FishyG/RobotSumo2022/README.md

# RobotSumo2022

Hello test :)

Hi test. I'm funny.
