FishyG/RobotSumo2022/Parts.md

# Digikey.ca:
## Alimentation découpage:
| No | Description | Prix unitaire | Qté |
|---|---|---|---|
| 718-2114-1-ND | CAP TANT POLY 100UF 6.3V 1206 | $1.041 | 50 |
| SK54B-LTPMSCT-ND  | DIODE SCHOTTKY 40V 5A DO214AA | $0.3854 | 100 |
| 296-38111-1-ND | IC REG CTRLR MULT TOPOLOGY 8SOIC  | $3.3708 | 25 |
| | | | |
| 296-25260-1-ND | MOSFET N-CH 25V 5A 6SON | $0.754 | 25 |
| | | | |
| 553-2864-ND | FIXED IND 2.7UH 3.5A 16 MOHM SMD  | $2.232 | 25 |
| PRL1632.015FCT-ND | RES 0.015 OHM 1W 1206 WIDE | $0.727 | 25 |
| PRL1632.009FCT-ND | RES 0.009 OHM 1W 1206 WIDE | $0.88 | 25 |

## Régulateurs:
| No | Description | Prix unitaire | Qté |
|---|---|---|---|
| LM1117MP-5.0/NOPBCT-ND | IC REG LINEAR 5V 800MA SOT223 | $1.552 | 25 |
| LM1117IMPX-3.3/NOPBCT-ND  | IC REG LIN 3.3V 800MA SOT223-4 | $1.40920 | 25 |
| TS3480CX33RFGCT-ND | Linear Voltage  3.3V 100mA SOT-23 | $0.8448 | 25 |
| MC33269DR2-5.06 | LINEAR REGULATOR 5v 800Ma SOIC-8  | ??? | 25 |

## USB à série:
| No | Description | Prix unitaire | Qté |
|---|---|---|---|
| 768-1007-1-ND | IC USB FS SERIAL UART 28-SSOP | $6.103 | 25 |
| 151-1206-1-ND | CONN RCPT USB2.0 MINI B SMD R/A | $0.6872 | 25 |
| 609-4618-1-ND | CONN RCPT USB2.0 MICRO B SMD R/A  | $0.4652 | 25 |

## Section processeur:
| No | Description | Prix unitaire | Qté |
|---|---|---|---|
| P8X32A-Q44-ND | IC MCU 32BIT 32KB ROM 44LQFP | $10.8316 | 25 |
| 644-1202-1-ND | CRYSTAL 5.0000MHZ 8PF SMD | $0.705 | 25 |
| 24LC512T-I/SNCT-ND | IC EEPROM 512KBIT I2C 8SOIC | $2.44 | 25 |

## Driver pour 1 moteur:
| No | Description | Prix unitaire | Qté |
|---|---|---|---|
| ZXBM5210-S-13DICT-ND  | IC MOTOR DRIVER 3V-18V 8SO | $1.524 | 50 |

# Mouser.ca: 
## Alimentation découpage:
| No | Description | Prix unitaire | Qté |
|---|---|---|---|
| 926-LM3478MA/NOPB | IC REG CTRLR MULT TOPOLOGY 8SOIC | $3.46 | 30 |
| 667-16SVPE180M | 180 µF 16 V Aluminum - Polymer Capacitors | $1.59 | 25 |
| | Radial, Can - SMD 11mOhm 2000 Hrs @ 105°C | | |

# IDK :shrug:
## Etc.
| No | Description | Prix unitaire | Qté |
|---|---|---|---|
| N/A | TCRT5000 - Capteur de sol | N/A | N/A |
| N/A | TL1838 - Capteur de proximité: | N/A | N/A |
| N/A | IR204 - DEL IR | N/A | N/A |
