FishyG/RobotSumo2022/3D/RobotSumoBody/body.FCStd

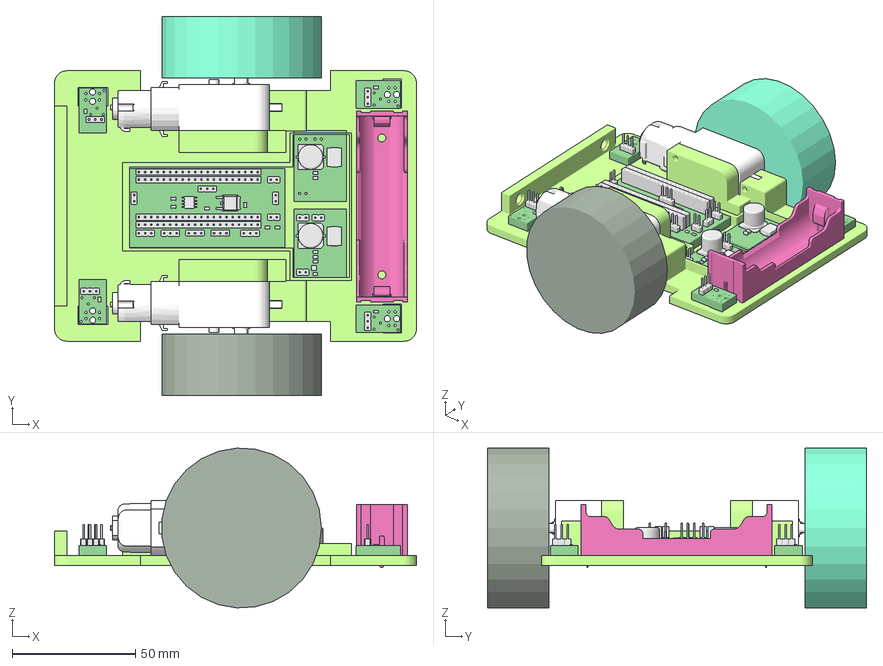
[picture p18: CAD file, 2022-12-01]
3D/RobotSumoBody/body.FCStd
147.0 x 154.0 x 64.9 mm
_autosave-Carte Mere PCB002
_autosave-Carte Mere PCB005
_autosave-Carte Mere PCB003
_autosave-Carte Mere PCB
_autosave-Carte Mere PCB006
_autosave-PowerSupply PCB002
_autosave-PowerSupply PCB001
wheel001
wheel002
DC Motor gearbox002
DC Motor gearbox001
18650_Holder
