FishyG/RobotSumo2022/3D/step/DC_Motor_20mm.STEP

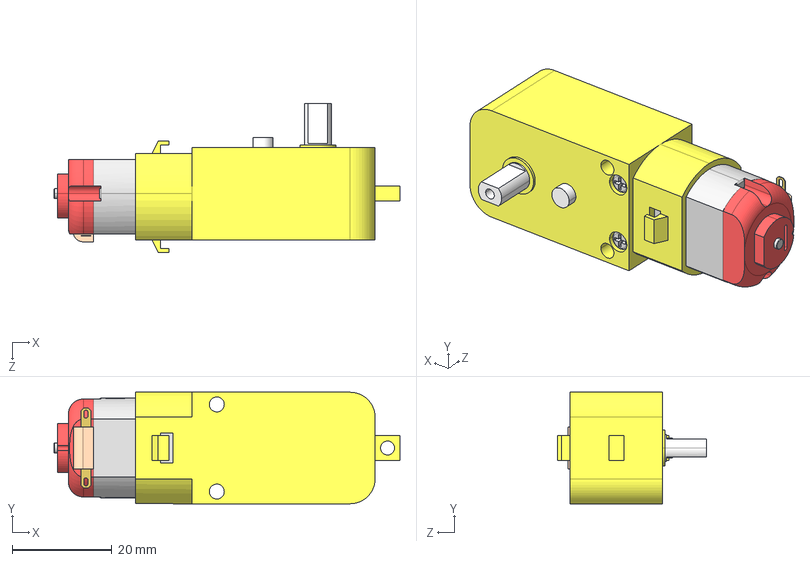
[picture p19: CAD file, 2022-12-01]
3D/step/DC_Motor_20mm.STEP
69.5 x 22.4 x 29.9 mm
