FishyG/RobotSumo2022/3D/stl/CpuBoard.stl

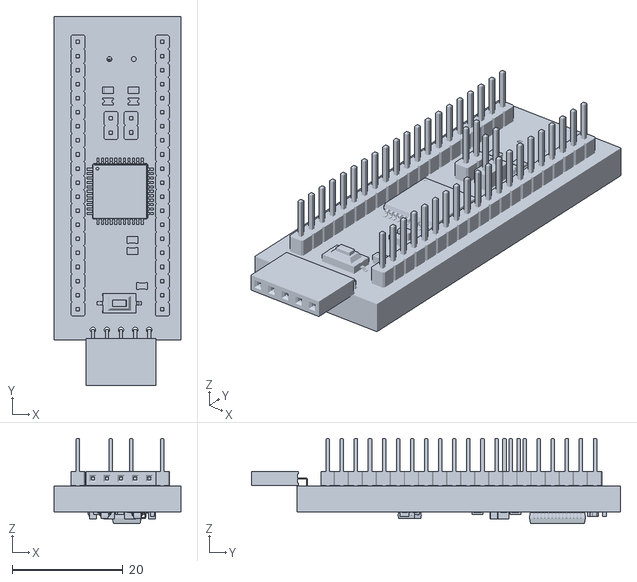
[picture p20: CAD file, 2022-10-06]
3D/stl/CpuBoard.stl
22.9 x 66.6 x 15.4
