FishyG/RobotSumo2022/3D/step/PowerSupply.step

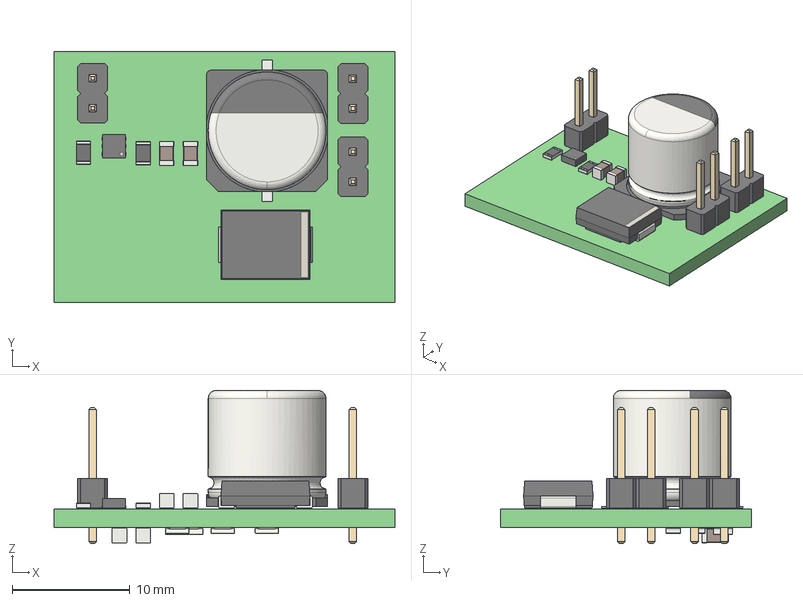
[picture p21: CAD file, 2022-10-06]
3D/step/PowerSupply.step
29.0 x 21.3 x 13.0 mm
_autosave-PowerSupply PCB
