FishyG/RobotSumo2022/3D/RobotSumoBody/body-Body.stl

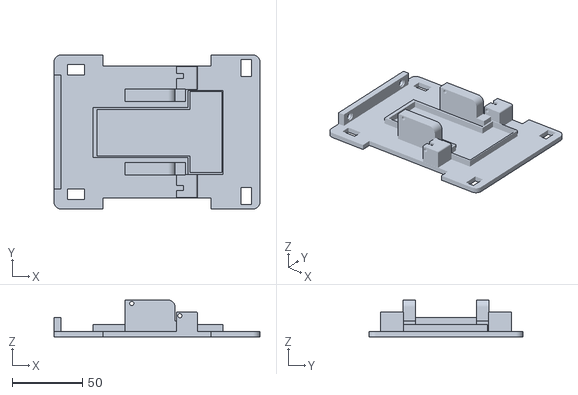
[picture p22: CAD file, 2022-12-01]
3D/RobotSumoBody/body-Body.stl
147.0 x 109.9 x 26.4
