FishyG/RobotSumo2022/3D/step/Capteur.step

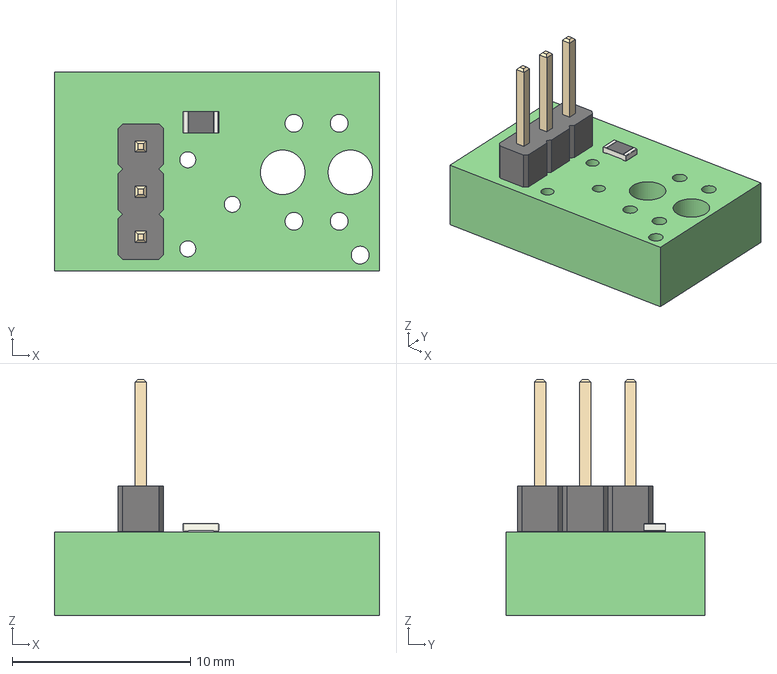
[picture p23: CAD file, 2022-10-06]
3D/step/Capteur.step
18.2 x 11.2 x 13.3 mm
_autosave-Carte Mere PCB
