FishyG/RobotSumo2022/3D/stl/CarteMere.stl

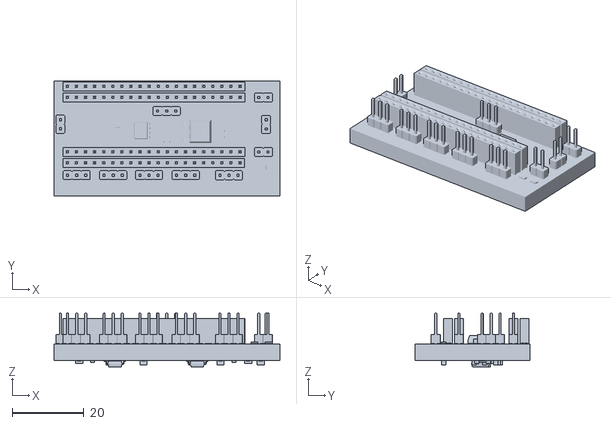
[picture p24: CAD file, 2022-10-06]
3D/stl/CarteMere.stl
63.2 x 32.2 x 15.1
