FishyG/RobotSumo2022/3D/stl/CpuBoardEsp.stl

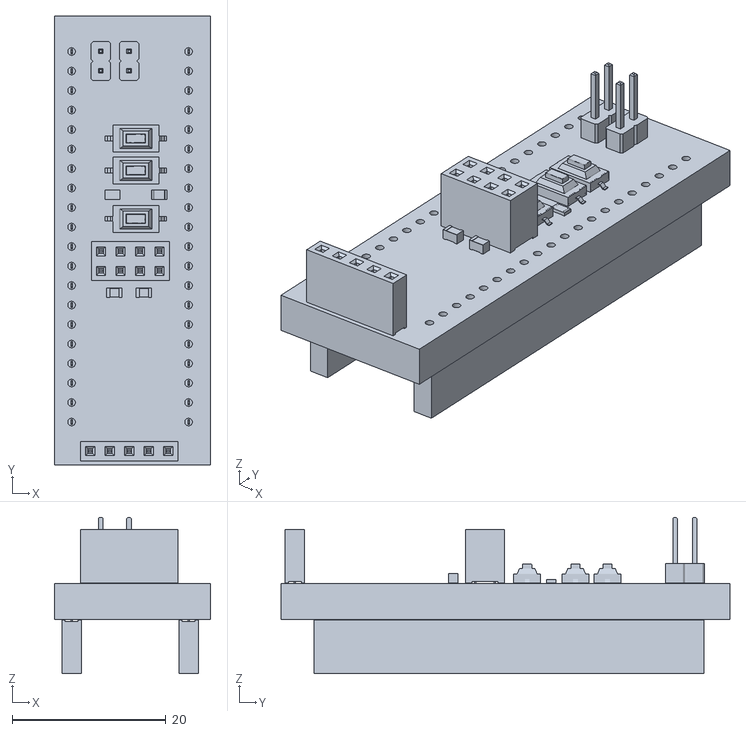
[picture p25: CAD file, 2022-10-06]
3D/stl/CpuBoardEsp.stl
20.3 x 58.4 x 20.3
