FishyG/RobotSumo2022/3D/stl/18650_Holderl.stl

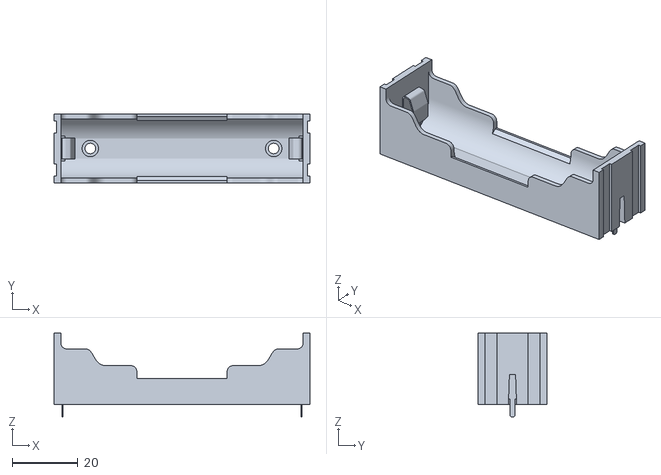
[picture p26: CAD file, 2022-10-06]
3D/stl/18650_Holderl.stl
77.7 x 20.8 x 25.5
