FishyG/RobotSumo2022/(list of files, cad)

Other CAD files:
Code/ControlRobotSumo/.objs/main.obj
Code/RobotSumoZP/.objs/main.obj
3D/RobotSumoBody/body-Motors_Wheels.stl
3D/stl/DC_Motor_20mm.STL
3D/stl/PowerSupply.stl
3D/stl/capteur.stl
