FishyG/RobotSumo2022/PCB/PowerSupply/WBDesign6V-2A_Startup.pdf

Rfadj 26.7 kOhm 63.0 m W; Com p; Isense; AGND PGND; Vin; Rcom p 2.74 kOhm 63.0 m W; Vout = 6.0V Iout = 2.0A D1 VF@Io= 550.0 m V VRRM= 40.0 V; Cin 100.0 µF 100.0 m Ohm; Cfilt 10.0 pF; Ccom p 18.0 nF 1.0 m Ohm; L1 2.7 µH 12.0 m Ohm; Rfilt 100.0 Ohm 63.0 m W; Ccom p2 1.0 nF 1.0 m Ohm; Cout 180.0 µF 11.0 m Ohm; Cbyp 100.0 nF 1.0 m Ohm; M1 VdsMax= 12.0 V IdsMax= 22.0 Am ps; Rsense 16.0 m Ohm 1.0 W; Rfb1 1000.0 Ohm 63.0 m W; Rfb2 3.74 kOhm 63.0 m W; Iout

Copyright © 2022, Texas Instruments Incorporated | 1 | ti.com/webench

WEBENCH®
Design Report LM3478MM/NOPB : LM3478MM/NOPB 3.5V-4.2V to 6.00V @ 2A August 25, 2022 10:10:40 GMT-05:00

## WEBENCH ® Design Report

Design : 4 LM3478MM/NOPB
LM3478MM/NOPB 3.5V-4.2V to 6.00V @ 2A

VinMin = 3.5V
VinMax = 4.2V
Vout = 6.0V
Iout = 2.0A

Device = LM3478MM/NOPB
Topology = Boost
Created = 2022-08-25 10:07:59.511 BOM Cost = $2.75
BOM Count = 16
Total Pd = 1.51W
1. With the low turn of voltage of the LM34x8 your power supply may current limit before you reach your working input voltage. If this happens, or to preempt this from happening, you can include a low pass RC filter from input voltage to Vin on the IC. Make sure the rise time on the RC network is slower than your supply's rise time.

## Electrical BOM

Name | Manufacturer | Part Number | Properties | Qty Price | Footprint
Cbyp | MuRata | GRM155R70J104KA01D (http://search.murata.co.jp/Ceramy/PnsearchViewAction.do) Series= X7R | Cap= 100.0 nF ESR= 1.0 mOhm VDC= 6.3 V IRMS= 0.0 A
1 | $0.01
| | | | | 0402 3 mm²
Ccomp | MuRata | GRM155R71C183KA01D (http://search.murata.co.jp/Ceramy/PnsearchViewAction.do) Series= X7R

Cap= 18.0 nF
ESR= 1.0 mOhm
VDC= 16.0 V
IRMS= 0.0 A

1 $0.01
0402 3 mm²
Ccomp2 | Yageo | CC0805KRX7R9BB102 (http://www.yageo.com/documents/recent/UPY%2DGPHC%5FX7R%5F6.3V%2Dto%2D50V%5F7.pdf) Series= X7R

Cap= 1.0 nF
ESR= 1.0 mOhm
VDC= 50.0 V
IRMS= 0.0 A

1 $0.01
0805 7 mm²
Cfilt | Samsung Electro- Mechanics | CL21C100JBANNNC (http://www.samsungsem.com/servlet/FileDownload?type%3Dspec%26file%3DCL21C100JBANNNC.pdf) Series= C0G/NP0 | Cap= 10.0 pF VDC= 50.0 V IRMS= 0.0 A
1 | $0.01
0805 7 mm²
Cin | Panasonic | 6TPH100MAEA Series= TPH | Cap= 100.0 uF ESR= 100.0 mOhm VDC= 6.3 V IRMS= 670.0 mA
1 | $0.32
CAPSMT_6_A09 11 mm²
Cout | Panasonic | 16SVPE180M Series= SVPE | Cap= 180.0 uF ESR= 11.0 mOhm VDC= 16.0 V IRMS= 4.46 A
1 | $0.50

CAPSMT_62_C10 74 mm²
D1 | Diodes Inc. | B540C-13-F (http://www.diodes.com/datasheets/ds13012.pdf) | VF@Io= 550.0 mV VRRM= 40.0 V
1 | $0.17

SMC 83 mm²

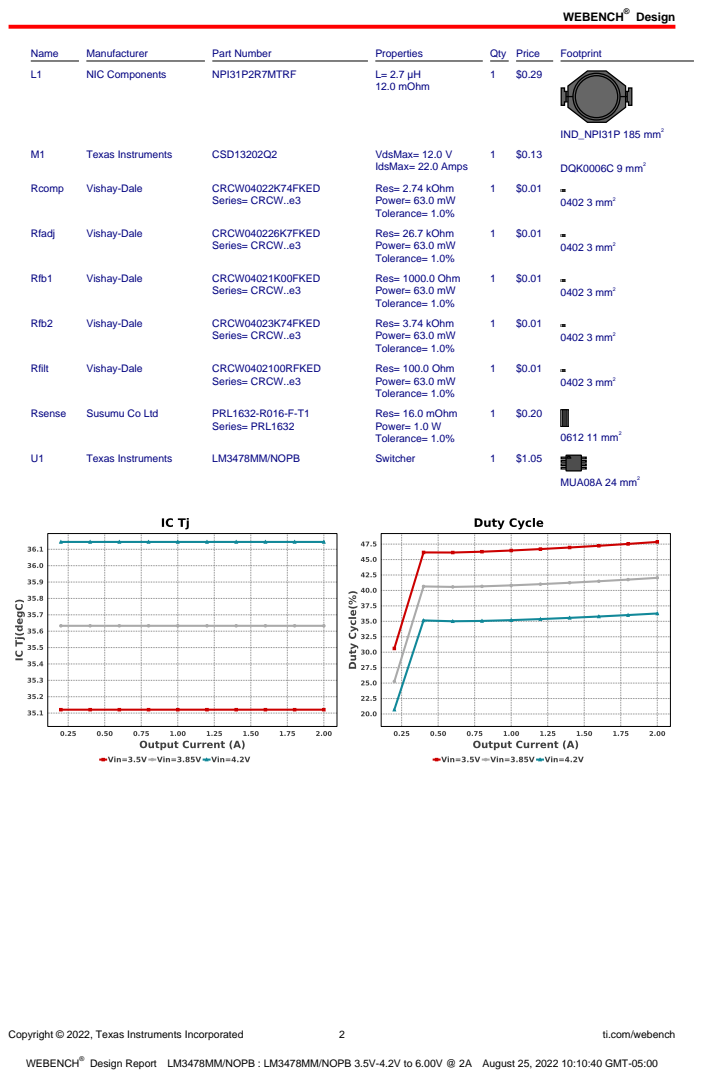
[picture p43: page 2]
Design; Copyright © 2022, Texas Instruments Incorporated; ti.com/webench; Name; Manufacturer; Part Number; Properties; Qty Price; Footprint; NIC Components; NPI31P2R7MTRF; 12.0 mOhm; IND_NPI31P 185 mm²; Texas Instruments; CSD13202Q2; VdsMax= 12.0 V; IdsMax= 22.0 Amps; DQK0006C 9 mm²; Rcomp; Vishay-Dale; CRCW04022K74FKED; Series= CRCW..e3; Res= 2.74 kOhm Power= 63.0 mW Tolerance= 1.0%; 0402 3 mm²; Rfadj; CRCW040226K7FKED; Res= 26.7 kOhm Power= 63.0 mW Tolerance= 1.0%; Rfb1; CRCW04021K00FKED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

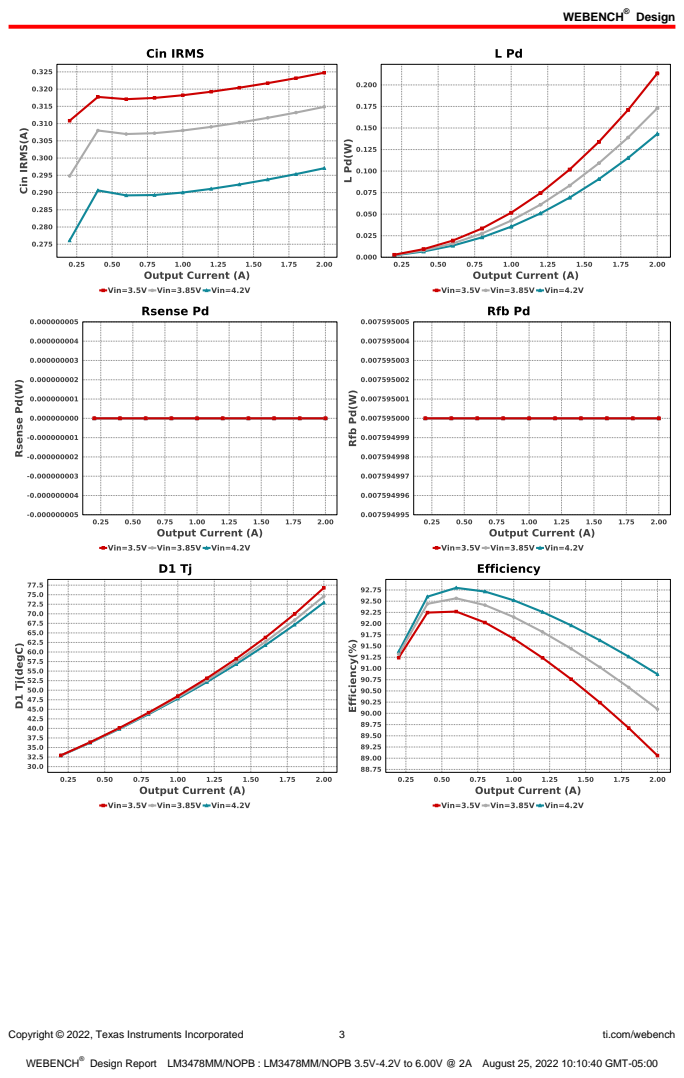
[picture p44: page 3]
Copyright © 2022, Texas Instruments Incorporated; ti.com/webench

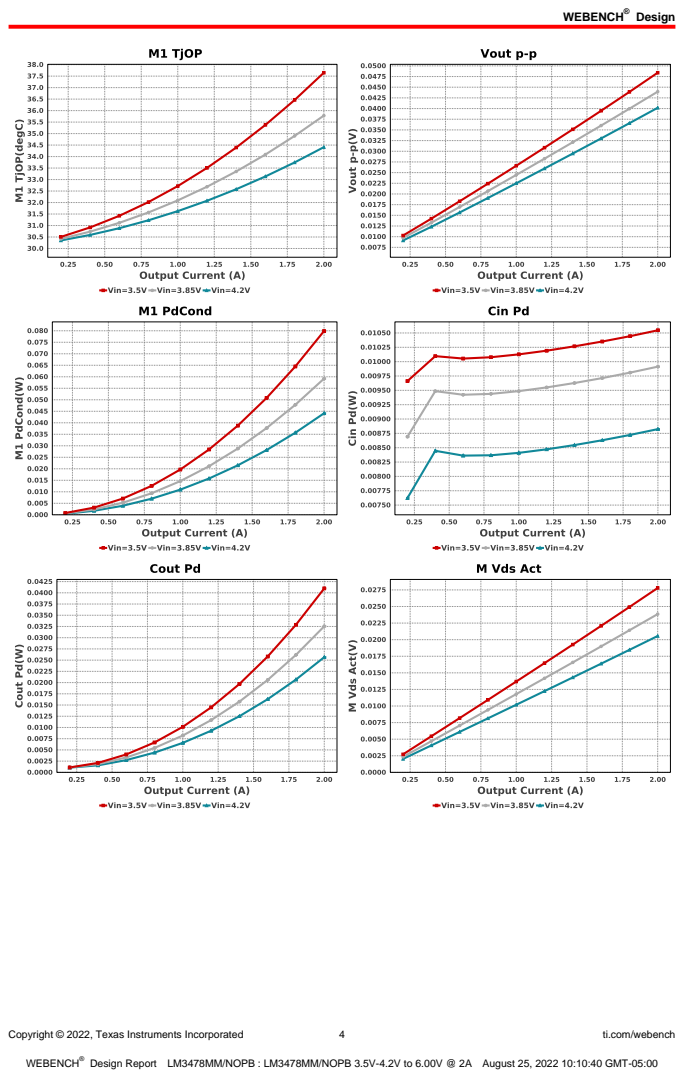
[picture p45: page 4]
Copyright © 2022, Texas Instruments Incorporated; ti.com/webench

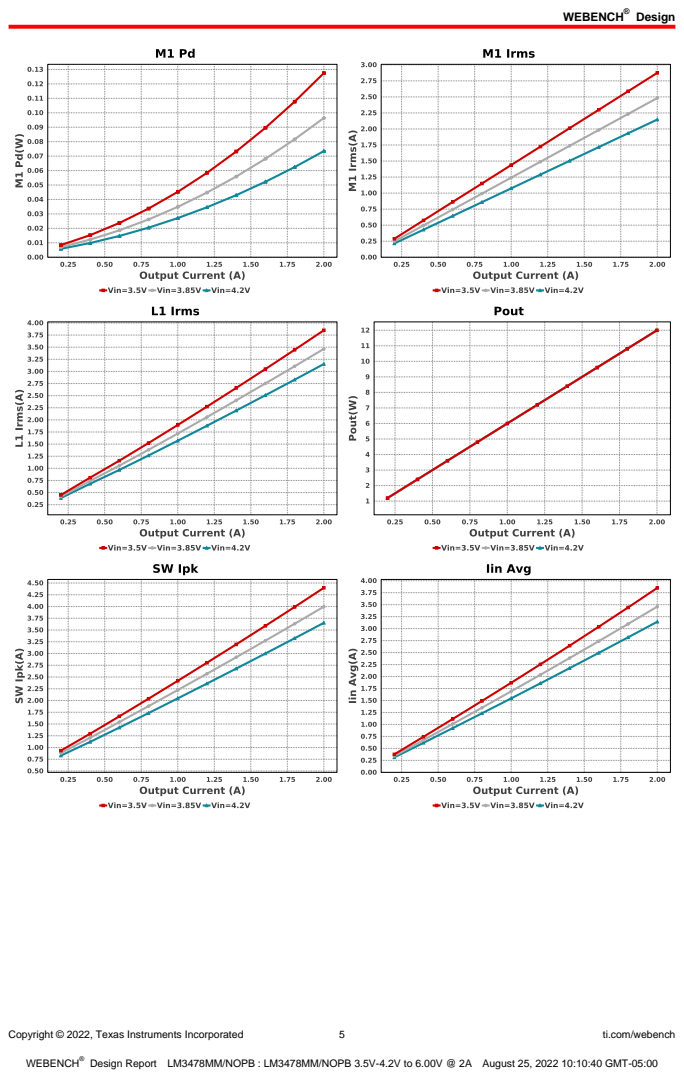
[picture p46: page 5]
Copyright © 2022, Texas Instruments Incorporated; ti.com/webench

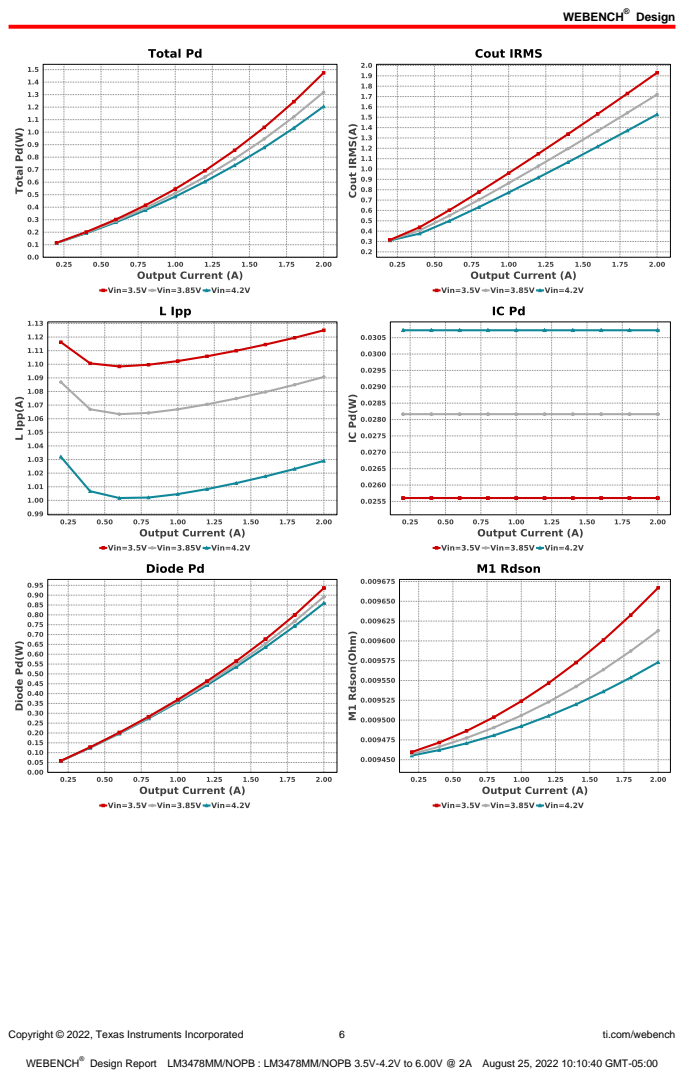
[picture p47: page 6]
Copyright © 2022, Texas Instruments Incorporated; ti.com/webench

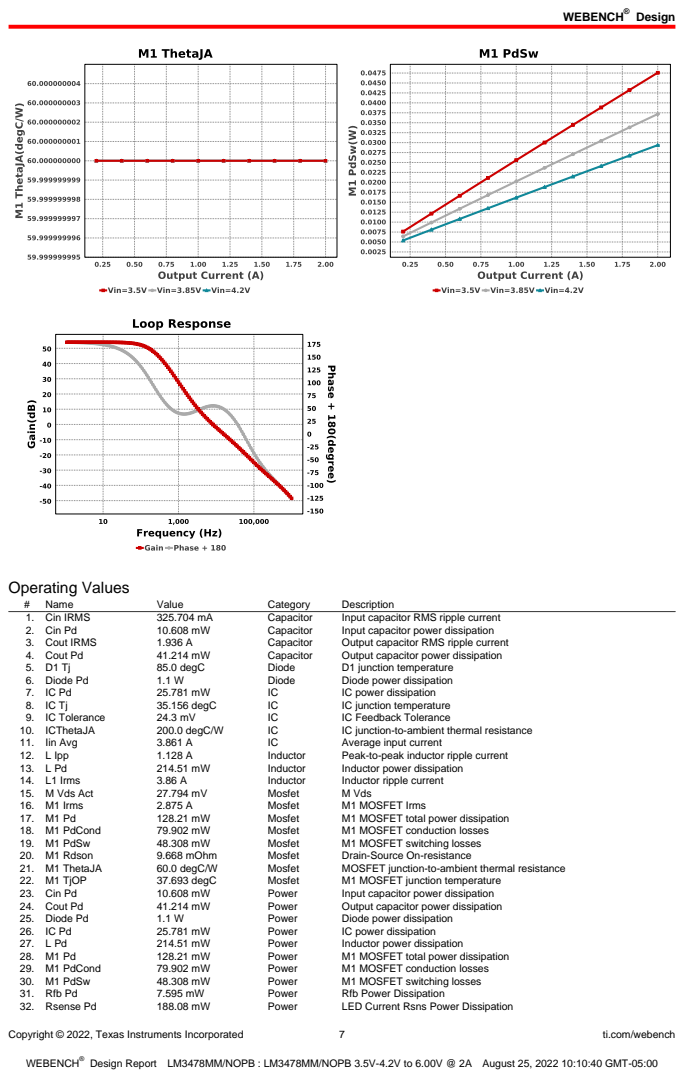
[picture p48: page 7]
Copyright © 2022, Texas Instruments Incorporated; ti.com/webench; Operating Values; Name; Value; Category; Description; 1. Cin IRMS; Capacitor; Input capacitor RMS ripple current; 2. Cin Pd; Input capacitor power dissipation; 3. Cout IRMS; Output capacitor RMS ripple current; 4. Cout Pd; Output capacitor power dissipation; 85.0 degC; Diode; D1 junction temperature; 6. Diode Pd; Diode power dissipation; IC power dissipation; 35.156 degC; IC junction temperature; 9. IC Tolerance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

Copyright © 2022, Texas Instruments Incorporated | 8 | ti.com/webench
# | Name | Value | Category | Description

33. Total Pd | 1.513 W | Power | Total Power Dissipation
34. Rfb Pd | 7.595 mW | Resistor | Rfb Power Dissipation
35. Rsense Pd | 188.08 mW | Resistor | LED Current Rsns Power Dissipation
36. BOM Count | 16 | System
| | | Information | Total Design BOM count
37. Cross Freq | 6.927 kHz | System
| | | Information | Bode plot crossover frequency
38. Duty Cycle | 47.995 % | System
| | | Information | Duty cycle
39. Efficiency | 88.802 % | System
| | | Information | Steady state efficiency
40. FootPrint | 431.0 mm² | System
| | | Information | Total Foot Print Area of BOM components
41. Frequency | 541.734 kHz | System
| | | Information | Switching frequency
42. Gain Marg | -16.683 dB | System
| | | Information | Bode Plot Gain Margin
43. Iout | 2.0 A | System
| | | Information | Iout operating point
44. Low Freq Gain | 52.246 dB | System
| | | Information | Gain at 1Hz
45. Mode | CCM | System
| | | Information | Conduction Mode
46. Phase Marg | 52.899 deg | System
| | | Information | Bode Plot Phase Margin
47. Pout | 12.0 W | System
| | | Information | Total output power
48. SW Ipk | 4.41 A | System
| | | Information | Peak switch current
49. Total BOM | $2.75 | System
| | | Information | Total BOM Cost
50. Vin | 3.5 V | System
| | | Information | Vin operating point
51. Vout | 6.0 V | System
| | | Information | Operational Output Voltage
52. Vout Actual | 5.972 V | System
| | | Information | Vout Actual calculated based on selected voltage divider resistors
53. Vout Tolerance | 3.553 % | System
| | | Information | Vout Tolerance based on IC Tolerance (no load) and voltage divider resistors if applicable
54. Vout p-p | 48.525 mV | System
| | | Information | Peak-to-peak output ripple voltage

## Design Inputs

Name | Value | Description
Iout | 2.0 | Maximum Output Current
VinMax | 4.2 | Maximum input voltage
VinMin | 3.5 | Minimum input voltage
Vout | 6.0 | Output Voltage
| base_pn | | LM3478 | Base Product Number
source | DC | Input Source Type
Ta | 30.0 | Ambient temperature


Copyright © 2022, Texas Instruments Incorporated | 9 | ti.com/webench

## Assembly

## Component Testing

Some published data on components in datasheets such as Capacitor ESR and Inductor DC resistance is based on conservative values that will guarantee that the components always exceed the specification. For design purposes it is usually better to work with typical values. Since this data is not always available it is a good practice to measure the Capacitance and ESR values of Cin and Cout, and the inductance and DC resistance of L1 before assembly of the board. Any large discrepancies in values should be electrically simulated in WEBENCH to check for instabilities and thermally simulated in WebTHERM to make sure critical temperatures are not exceeded.

## Soldering Component to Board

If board assembly is done in house it is best to tack down one terminal of a component on the board then solder the other terminal. For surface mount parts with large tabs, such as the DPAK, the tab on the back of the package should be pre-tinned with solder, then tacked into place by one of the pins. To solder the tab town to the board place the iron down on the board while resting against the tab, heating both surfaces simultaneously. Apply light pressure to the top of the plastic case until the solder flows around the part and the part is flush with the PCB. If the solder is not flowing around the board you may need a higher wattage iron (generally 25W to 30W is enough).

## Initial Startup of Circuit

It is best to initially power up the board by setting the input supply voltage to the lowest operating input voltage 3.5V and set the input supply's current limit to zero. With the input supply off connect up the input supply to Vin and GND. Connect a digital volt meter and a load if needed to set the minimum Iout of the design from Vout and GND. Turn on the input supply and slowly turn up the current limit on the input supply. If the voltage starts to rise on the input supply continue increasing the input supply current limit while watching the output voltage. If the current increases on the input supply, but the voltage remains near zero, then there may be a short or a component misplaced on the board. Power down the board and visually inspect for solder bridges and recheck the diode and capacitor polarities. Once the power supply circuit is operational then more extensive testing may include full load testing, transient load and line tests to compare with simulation results.

## Load Testing

The setup is the same as the initial startup, except that an additional digital voltmeter is connected between Vin and GND, a load is connected between Vout and GND and a current meter is connected in series between Vout and the load. The load must be able to handle at least rated output power + 50% ( 7.5 watts for this design). Ideally the load is supplied in the form of a variable load test unit. It can also be done in the form of suitably large power resistors. When using an oscilloscope to measure waveforms on the prototype board, the ground leads of the oscilloscope probes should be as short as possible and the area of the loop formed by the ground lead should be kept to a minimum. This will help reduce ground lead inductance and eliminate EMI noise that is not actually present in the circuit.

## WEBENCH® Electrical Simulation Report

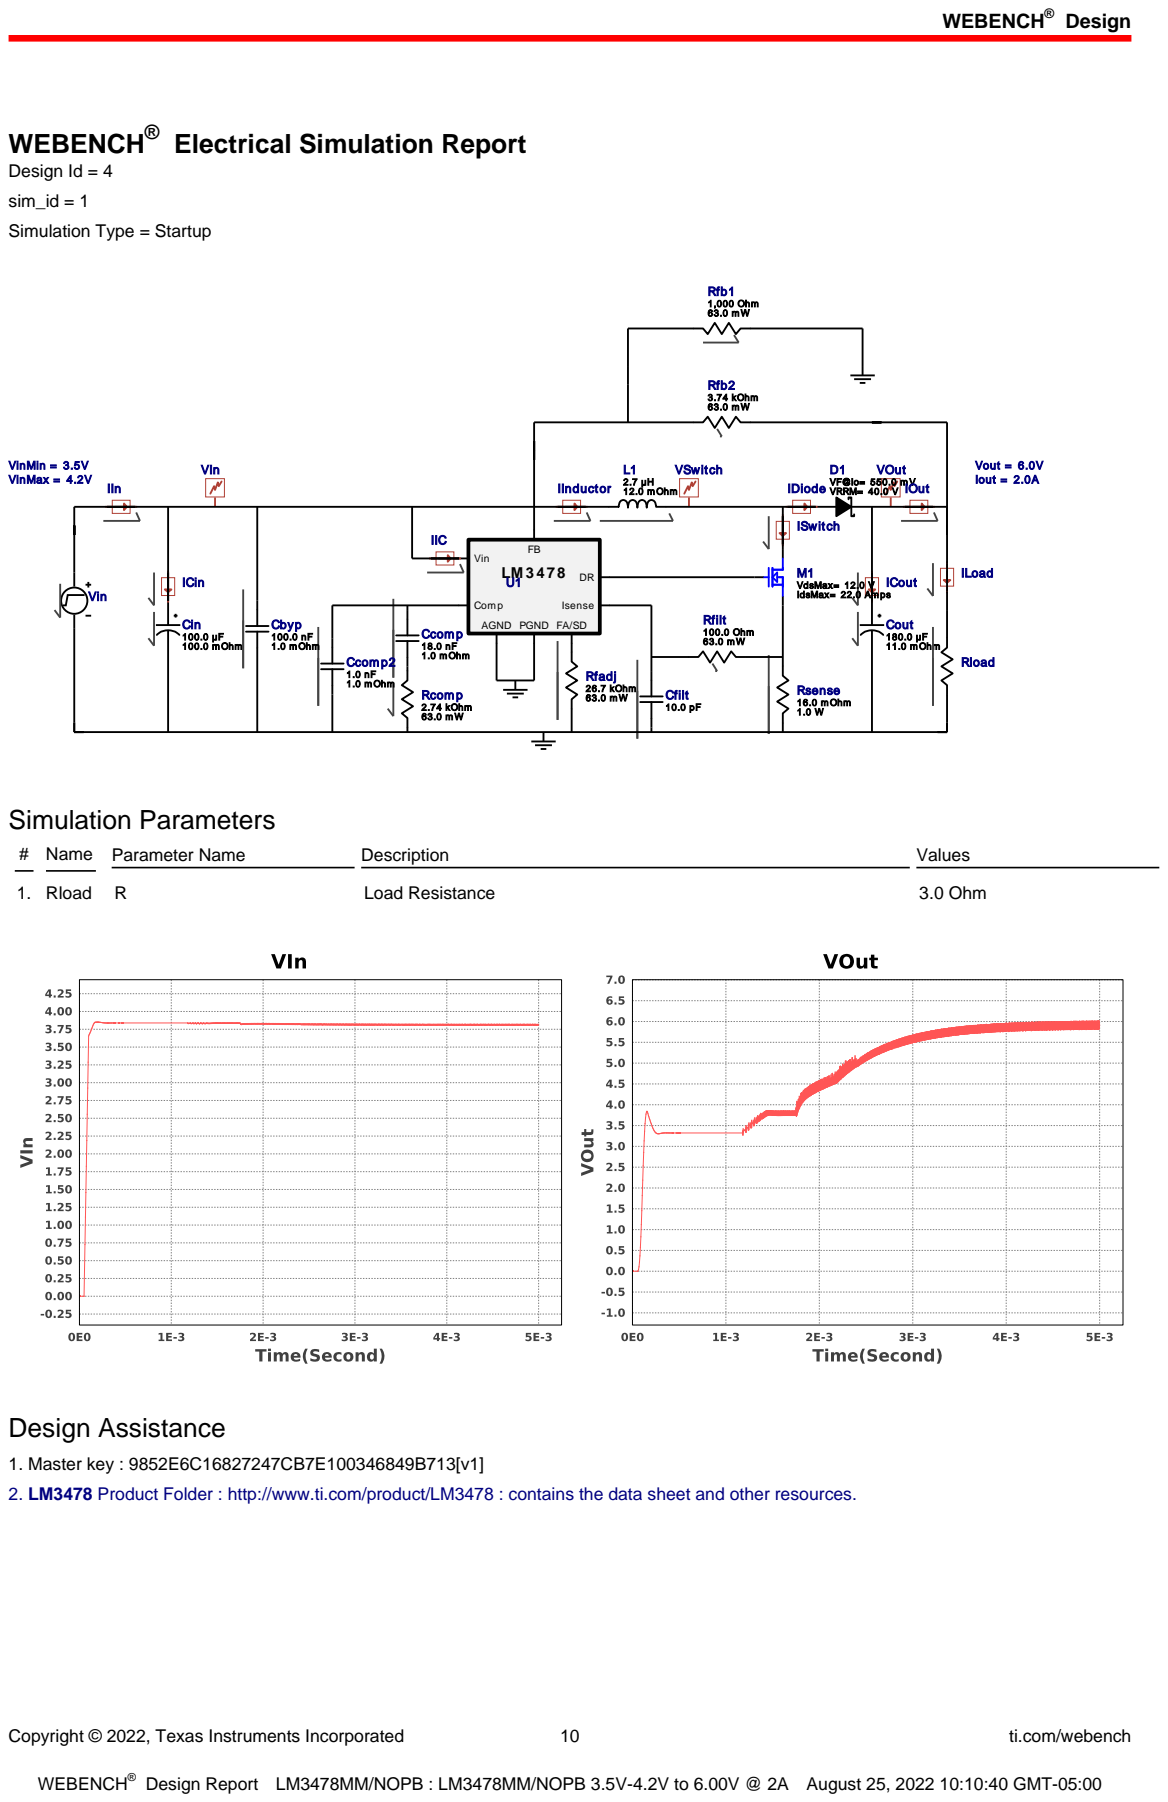
[picture p49: page 10]
Copyright © 2022, Texas Instruments Incorporated; ti.com/webench; Rfadj 26.7 kOhm 63.0 m W; VinMin = 3.5V; VinMax = 4.2V; VIn; Com p; Isense; AGND PGND; Vin; Rcom p 2.74 kOhm 63.0 m W; Vout = 6.0V; Iout = 2.0A D1; VOut; VF@Io= 550.0 m V VRRM= 40.0 V; Cin 100.0 µF 100.0 m Ohm; Cfilt 10.0 pF; ICin; ICout; IDiode; IIC; Ccom p 18.0 nF 1.0 m Ohm; IInductor; L1 2.7 µH 12.0 m Ohm; Rfilt 100.0 Ohm 63.0 m W; VSwitch; Ccom p2 1.0 nF 1.0 m Ohm; Cout 180.0 µF 11.0 m Ohm; Cbyp 100.0 nF 1.0 m Ohm; IIn; IOut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

Design Id = 4
sim_id = 1
Simulation Type = Startup

1. Master key : 9852E6C16827247CB7E100346849B713[v1]
2. LM3478 Product Folder : http://www.ti.com/product/LM3478 : contains the data sheet and other resources.

Copyright © 2022, Texas Instruments Incorporated | 11 | ti.com/webench

Important Notice and Disclaimer

TI provides technical and reliability data (including datasheets), design resources (including reference designs), application or other design advice, web tools, safety information, and other resources AS IS and with all faults, and disclaims all warranties. These resources are intended for skilled developers designing with TI products. You are solely responsible for (1) selecting the appropriate TI products for your application, (2) designing, validating and testing your application, and (3) ensuring your application meets applicable standards, and any other safety, security, or other requirements.

These resources are subject to change without notice. TI grants you permission to use these resources only for development of an application that uses the TI products described in the resource. Other reproduction and display of these resources is prohibited. No license is granted to any other TI intellectual property right or to any third party intellectual property right. TI disclaims responsibility for, and you will fully indemnify TI and its representatives against, any claims, damages, costs, losses, and liabilities arising out of your use of these resources.

Providing these resources does not expand or otherwise alter TI's applicable Terms of Sale or other applicable terms available either on ti.com or provided in conjunction with TI products.
