FishyG/RobotSumo2022/PCB/CpuBoard/CpuBoard.kicad_pcb

## KiCad design PCB/CpuBoard/CpuBoard.kicad_pcb (2022-09-16)

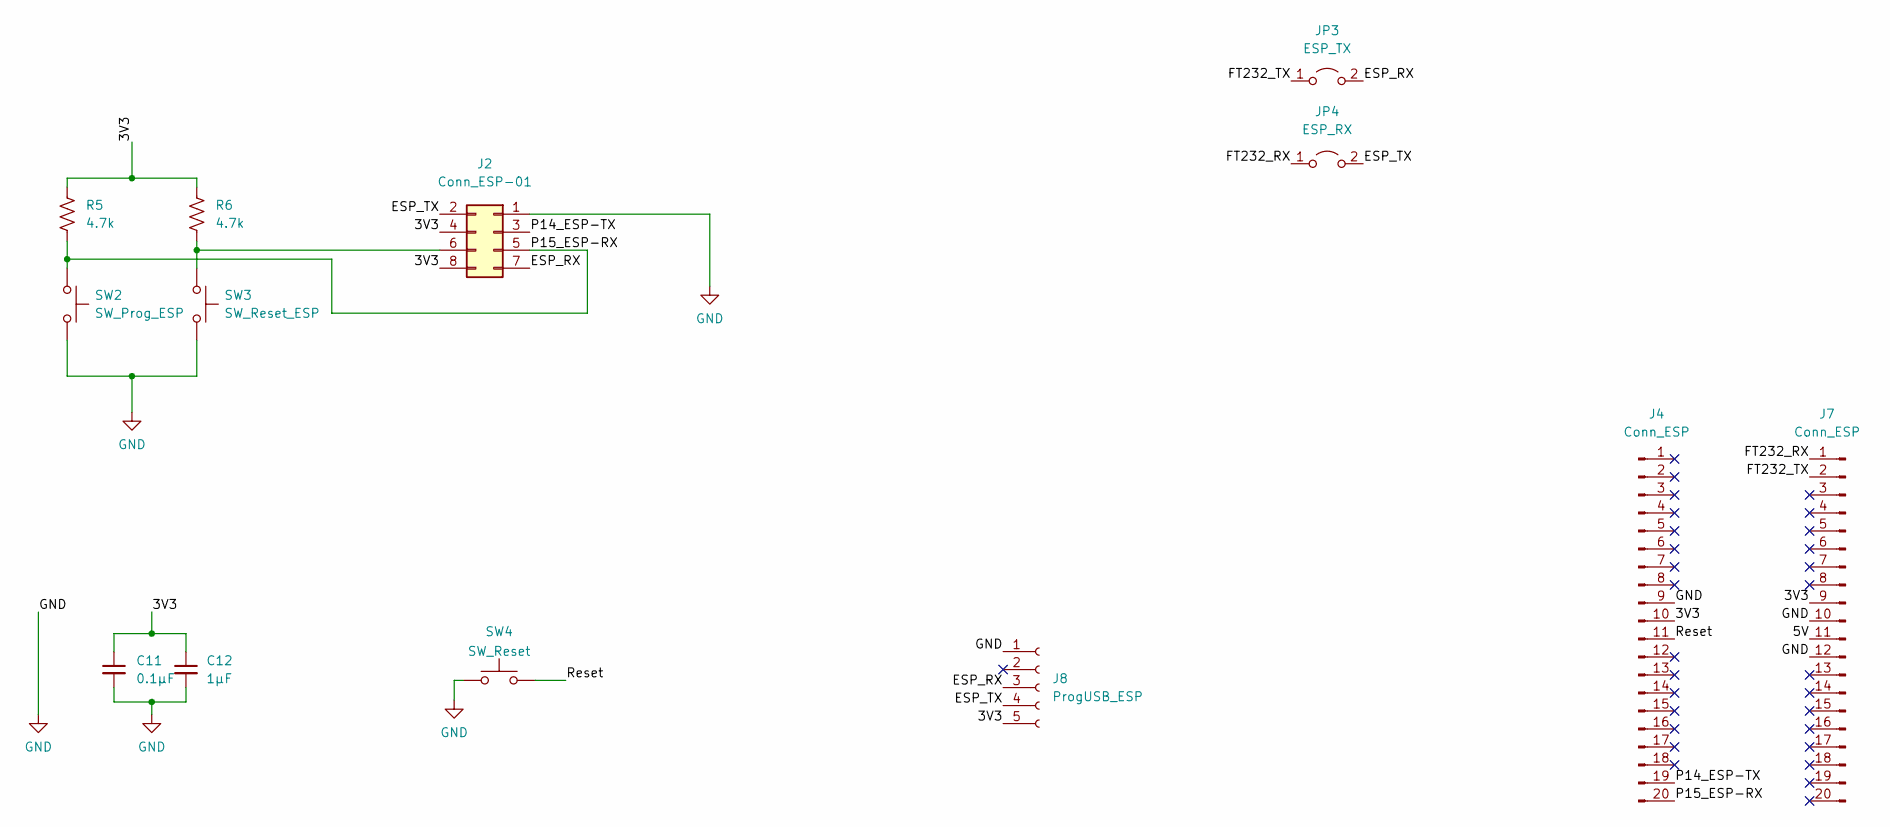
[picture p86: schematic ESP-01.kicad_sch]

Parts:
C11: 0.1µF; C_0805_2012Metric_Pad1.18x1.45mm_HandSolder
C12: 1µF; C_0805_2012Metric_Pad1.18x1.45mm_HandSolder
J2: Conn_ESP-01; PinSocket_2x04_P2.54mm_Vertical
J4: Conn_ESP; PinSocket_1x20_P2.54mm_Vertical
J7: Conn_ESP; PinHeader_1x20_P2.54mm_Vertical
J8: ProgUSB_ESP; PinSocket_1x05_P2.54mm_Vertical
JP3: ESP_TX; PinHeader_1x02_P2.54mm_Vertical
JP4: ESP_RX; PinHeader_1x02_P2.54mm_Vertical
R5, R6: 4.7k; R_0805_2012Metric_Pad1.20x1.40mm_HandSolder
SW2: SW_Prog_ESP; SW_SPST_CK_RS282G05A3
SW3: SW_Reset_ESP; SW_SPST_CK_RS282G05A3
SW4: SW_Reset; SW_SPST_CK_RS282G05A3

Connections:
/ESP-01/3V3: C11.1, C12.1, J2.4, J2.8, J4.10, J7.9, J8.5, R5.1, R6.1
/ESP-01/5V: J7.11
/ESP-01/ESP_RX: J2.7, J8.3, JP3.2 (B)
/ESP-01/ESP_TX: J2.2, J8.4, JP4.2 (B)
/ESP-01/FT232_RX: J7.1, JP4.1 (A)
/ESP-01/FT232_TX: J7.2, JP3.1 (A)
/ESP-01/P14_ESP-TX: J2.3, J4.19
/ESP-01/P15_ESP-RX: J2.5, J4.20, R5.2, SW2.1
/ESP-01/Reset: J4.11, SW4.2
GND: C11.2, C12.2, J2.1, J4.9, J7.10, J7.12, J8.1, SW2.2, SW3.2, SW4.1; also elsewhere on the board
unnamed: J2.6, R6.2, SW3.1

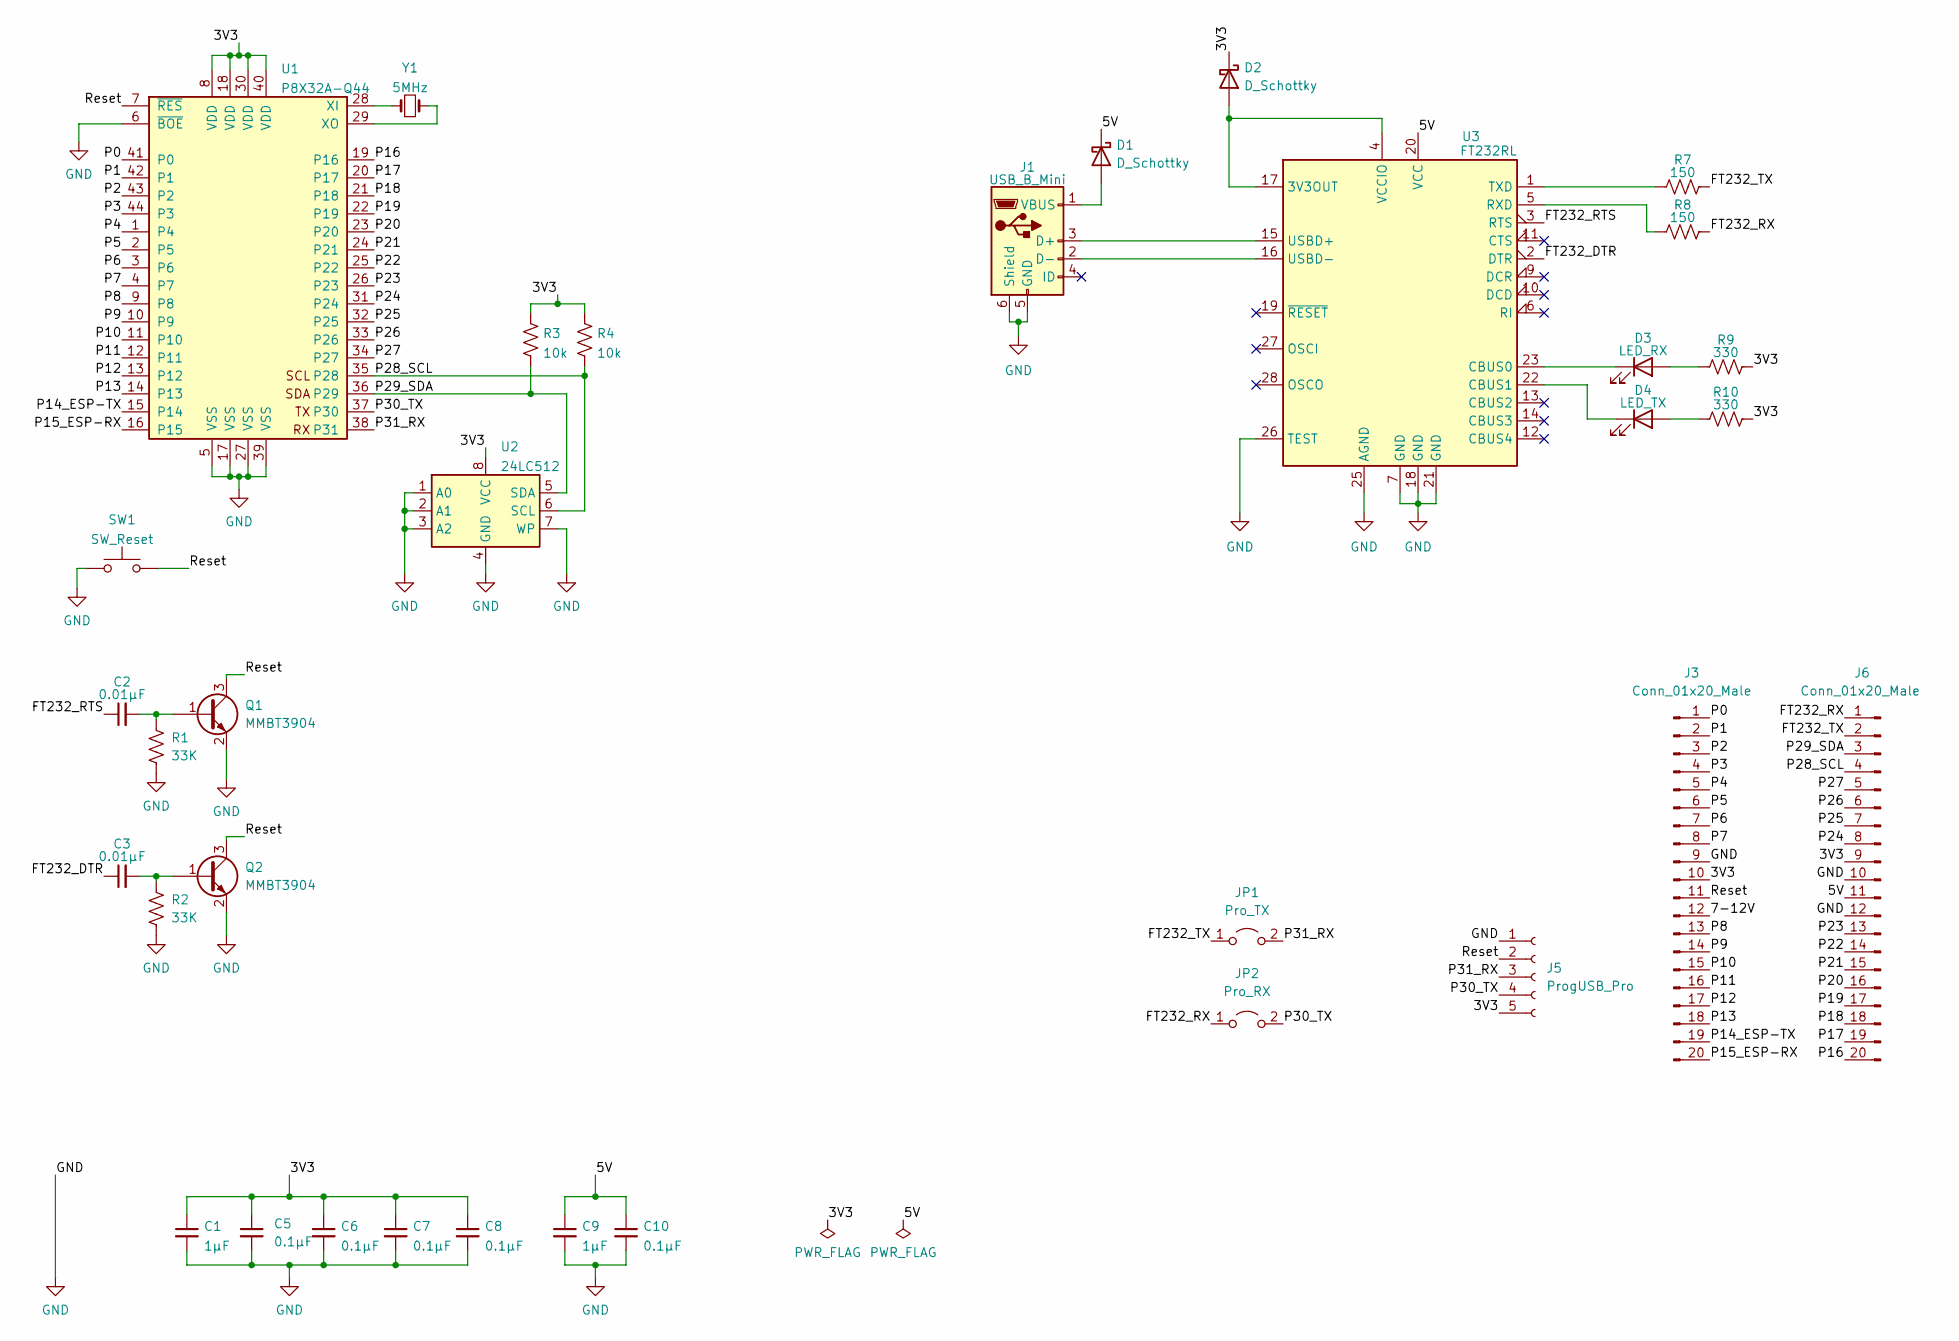
[picture p87: schematic Propeller.kicad_sch]

Parts:
C1: 1µF; C_0805_2012Metric_Pad1.18x1.45mm_HandSolder
C2, C3: 0.01µF; C_0805_2012Metric_Pad1.18x1.45mm_HandSolder
C5, C6, C7, C8: 0.1µF; C_0805_2012Metric_Pad1.18x1.45mm_HandSolder
C9: 1µF; C_0603_1608Metric_Pad1.08x0.95mm_HandSolder
C10: 0.1µF; C_0603_1608Metric_Pad1.08x0.95mm_HandSolder
D1, D2: D_Schottky; D_0805_2012Metric_Pad1.15x1.40mm_HandSolder
D3: LED_RX; D_0805_2012Metric_Pad1.15x1.40mm_HandSolder
D4: LED_TX; D_0805_2012Metric_Pad1.15x1.40mm_HandSolder
J1: USB_B_Mini; USB_Mini-B_Wuerth_65100516121_Horizontal
J3, J6: Conn_01x20_Male; PinHeader_1x20_P2.54mm_Vertical
J5: ProgUSB_Pro; PinSocket_1x05_P2.54mm_Horizontal
JP1: Pro_TX; PinHeader_1x02_P2.54mm_Vertical
JP2: Pro_RX; PinHeader_1x02_P2.54mm_Vertical
Q1, Q2: MMBT3904; SOT-23
R1, R2: 33K; R_0805_2012Metric_Pad1.20x1.40mm_HandSolder
R3, R4: 10k; R_0805_2012Metric_Pad1.20x1.40mm_HandSolder
R7, R8: 150; R_0805_2012Metric_Pad1.20x1.40mm_HandSolder
R9, R10: 330; R_0805_2012Metric_Pad1.20x1.40mm_HandSolder
SW1: SW_Reset; SW_SPST_CK_RS282G05A3
U1: P8X32A-Q44; LQFP-44_10x10mm_P0.8mm
U2: 24LC512; SOIC-8-1EP_3.9x4.9mm_P1.27mm_EP2.41x3.81mm
U3: FT232RL; SSOP-28_5.3x10.2mm_P0.65mm
Y1: 5MHz; Crystal_SMD_MicroCrystal_CC1V-T1A-2Pin_8.0x3.7mm_HandSolder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

Connections:
/Propeller/3V3: C1.1, C5.1, C6.1, C7.1, C8.1, D2.1 (K), J3.10, J5.5, J6.9, R3.1, R4.1, R9.2, R10.2, U1.8 (VDD), U1.18 (VDD), U1.30 (VDD), U1.40 (VDD), U2.8 (VCC)
/Propeller/5V: C9.1, C10.1, D1.1 (K), J6.11, U3.20 (VCC)
/Propeller/7-12V: J3.12
/Propeller/FT232_DTR: C3.1, U3.2 (DTR)
/Propeller/FT232_RTS: C2.1, U3.3 (RTS)
/Propeller/FT232_RX: J6.1, JP2.1 (A), R8.2
/Propeller/FT232_TX: J6.2, JP1.1 (A), R7.2
/Propeller/P0: J3.1, U1.41 (P0)
/Propeller/P1: J3.2, U1.42 (P1)
/Propeller/P2: J3.3, U1.43 (P2)
/Propeller/P3: J3.4, U1.44 (P3)
/Propeller/P4: J3.5, U1.1 (P4)
/Propeller/P5: J3.6, U1.2 (P5)
/Propeller/P6: J3.7, U1.3 (P6)
/Propeller/P7: J3.8, U1.4 (P7)
/Propeller/P8: J3.13, U1.9 (P8)
/Propeller/P9: J3.14, U1.10 (P9)
/Propeller/P10: J3.15, U1.11 (P10)
/Propeller/P11: J3.16, U1.12 (P11)
/Propeller/P12: J3.17, U1.13 (P12)
/Propeller/P13: J3.18, U1.14 (P13)
/Propeller/P14_ESP-TX: J3.19, U1.15 (P14)
/Propeller/P15_ESP-RX: J3.20, U1.16 (P15)
/Propeller/P16: J6.20, U1.19 (P16)
/Propeller/P17: J6.19, U1.20 (P17)
/Propeller/P18: J6.18, U1.21 (P18)
/Propeller/P19: J6.17, U1.22 (P19)
/Propeller/P20: J6.16, U1.23 (P20)
/Propeller/P21: J6.15, U1.24 (P21)
/Propeller/P22: J6.14, U1.25 (P22)
/Propeller/P23: J6.13, U1.26 (P23)
/Propeller/P24: J6.8, U1.31 (P24)
/Propeller/P25: J6.7, U1.32 (P25)
/Propeller/P26: J6.6, U1.33 (P26)
/Propeller/P27: J6.5, U1.34 (P27)
/Propeller/P28_SCL: J6.4, R4.2, U1.35 (P28), U2.6 (SCL)
/Propeller/P29_SDA: J6.3, R3.2, U1.36 (P29), U2.5 (SDA)
/Propeller/P30_TX: J5.4, JP2.2 (B), U1.37 (P30)
/Propeller/P31_RX: J5.3, JP1.2 (B), U1.38 (P31)
/Propeller/Reset: J3.11, J5.2, Q1.3 (C), Q2.3 (C), SW1.2, U1.7 (~RES)
GND: C1.2, C5.2, C6.2, C7.2, C8.2, C9.2, C10.2, J1.5 (GND), J1.6 (Shield), J3.9, J5.1, J6.10, J6.12, Q1.2 (E), Q2.2 (E), R1.2, R2.2, SW1.1, U1.5 (VSS), U1.6 (~BOE), U1.17 (VSS), U1.27 (VSS), U1.39 (VSS), U2.1 (A0), U2.2 (A1), U2.3 (A2), U2.4 (GND), U2.7 (WP), U3.7 (GND), U3.18 (GND), U3.21 (GND), U3.25 (AGND), U3.26 (TEST); also elsewhere on the board
unnamed: C2.2, Q1.1 (B), R1.1
unnamed: C3.2, Q2.1 (B), R2.1
unnamed: D1.2 (A), J1.1 (VBUS)
unnamed: D2.2 (A), U3.4 (VCCIO), U3.17 (3V3OUT)
unnamed: D3.1 (K), U3.23 (CBUS0)
unnamed: D3.2 (A), R9.1
unnamed: D4.1 (K), U3.22 (CBUS1)
unnamed: D4.2 (A), R10.1
unnamed: J1.2 (D-), U3.16 (USBD-)
unnamed: J1.3 (D+), U3.15 (USBD+)
unnamed: R7.1, U3.1 (TXD)
unnamed: R8.1, U3.5 (RXD)
unnamed: U1.28 (XI), Y1.1
unnamed: U1.29 (XO), Y1.2

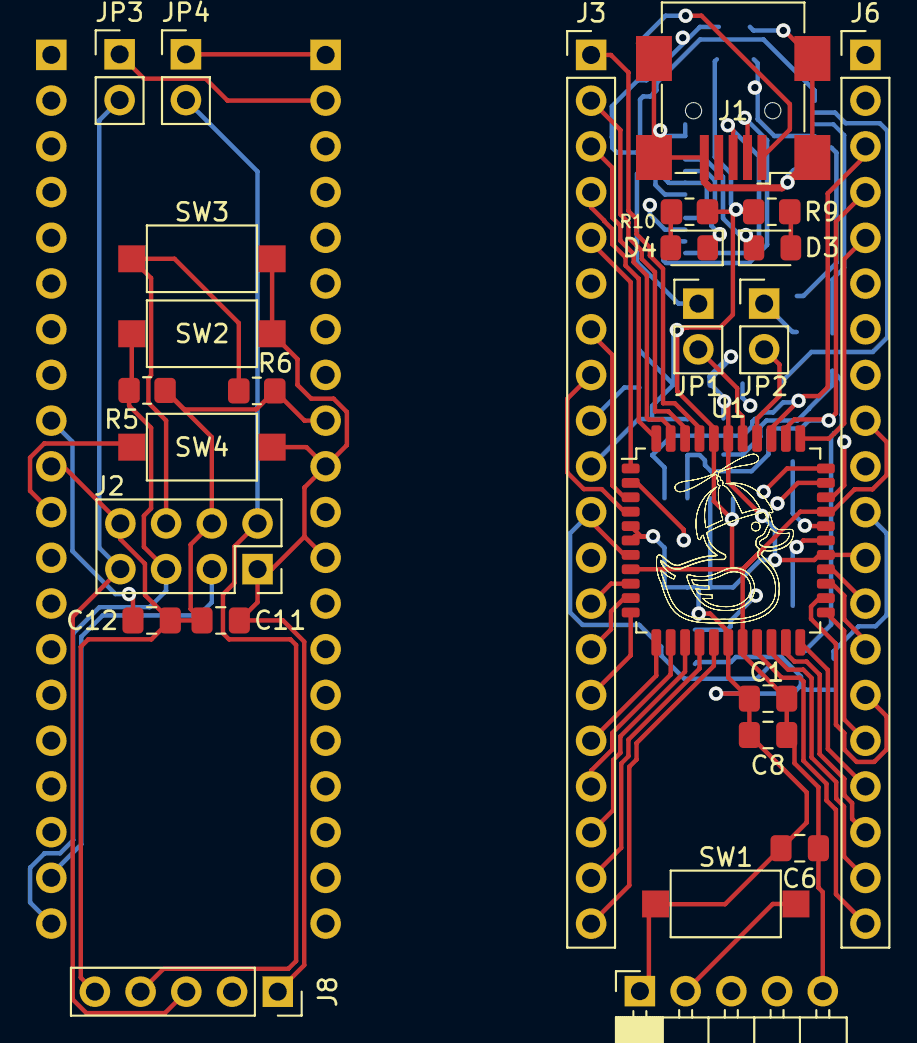
[picture p88: board CpuBoard.kicad_pcb from above]

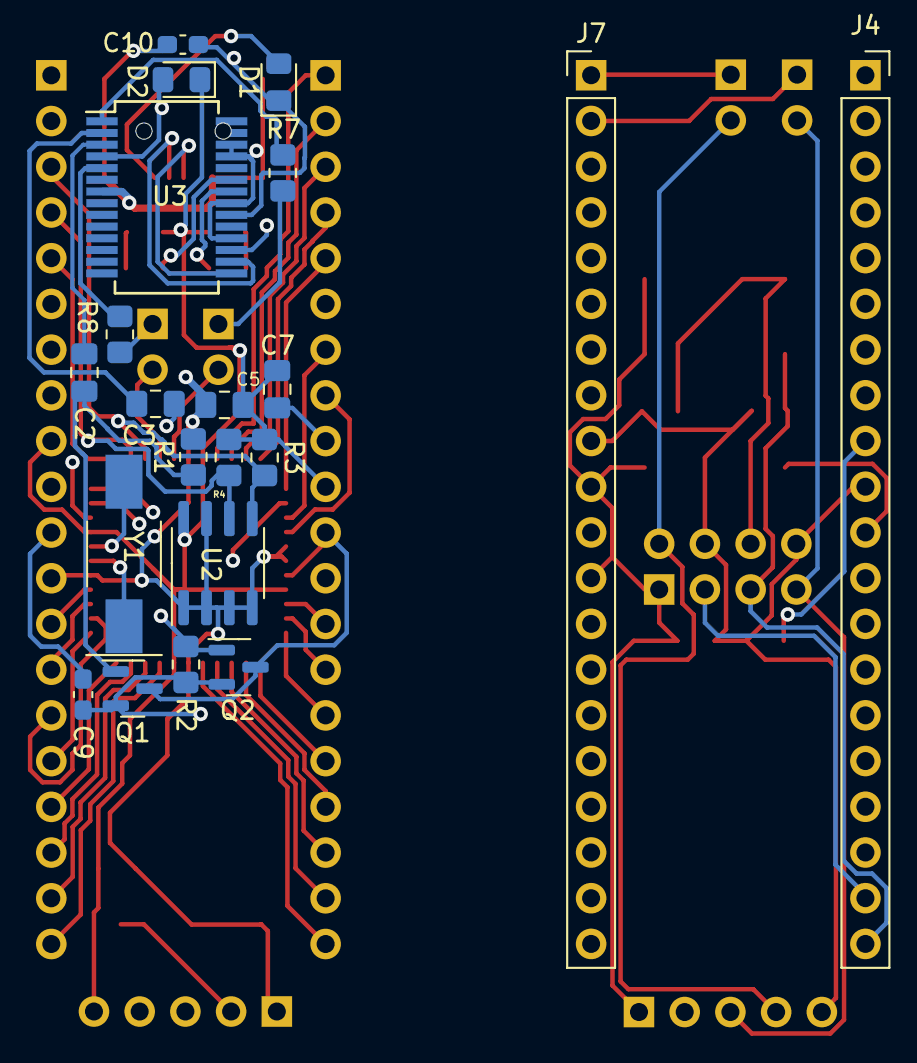
[picture p89: board CpuBoard.kicad_pcb from below]

Board: 4 copper layers, 47 parts (21 on the bottom side), 63 nets.
