FishyG/RobotSumo2022/PCB/Carte Mere/Carte Mere.kicad_pcb

## KiCad design PCB/Carte Mere/Carte Mere.kicad_pcb (2022-09-16)

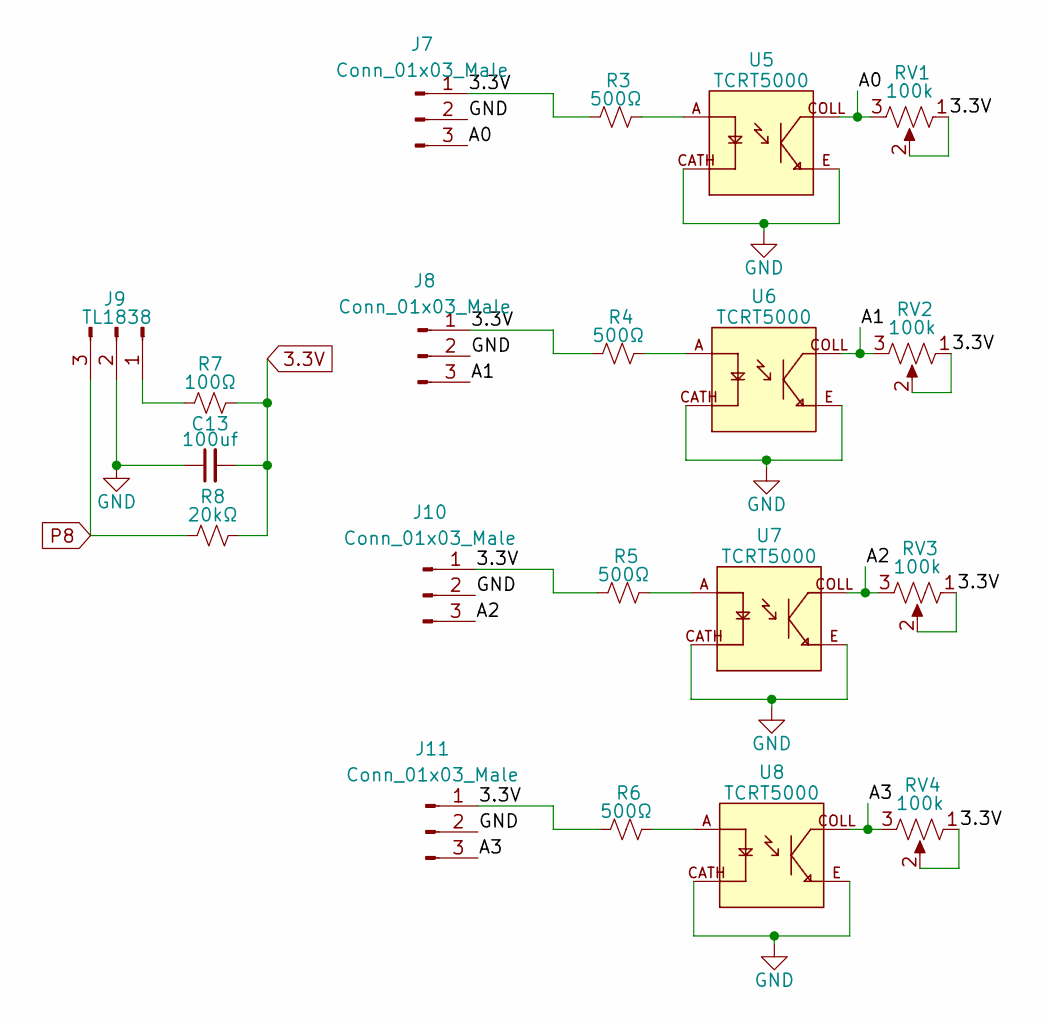
[picture p90: schematic Capteur infrarouge.kicad_sch]

Parts:
C13: 100uf; C_0805_2012Metric_Pad1.18x1.45mm_HandSolder
J7, J8, J10, J11: Conn_01x03_Male; PinHeader_1x03_P2.54mm_Vertical
J9: TL1838; PinHeader_1x03_P2.54mm_Vertical
R3, R4, R5, R6: 500Ω; R_0805_2012Metric_Pad1.20x1.40mm_HandSolder
R7: 100Ω; R_0805_2012Metric_Pad1.20x1.40mm_HandSolder
R8: 20kΩ; R_0805_2012Metric_Pad1.20x1.40mm_HandSolder
RV1, RV2, RV3, RV4: 100k; Potentiometer_ACP_CA6-H2,5_Horizontal
U5, U6, U7, U8: TCRT5000; OPTO_TCRT5000; PARTREV 1.7

Connections:
3.3V: C13.2, J7.1, J8.1, J10.1, J11.1, R3.1, R4.1, R5.1, R6.1, R7.2, R8.2, RV1.1, RV1.2, RV2.1, RV2.2, RV3.1, RV3.2, RV4.1, RV4.2; also elsewhere on the board
/Capteur/A0: J7.3, RV1.3, U5.COLL
/Capteur/A1: J8.3, RV2.3, U6.COLL
/Capteur/A2: J10.3, RV3.3, U7.COLL
/Capteur/A3: J11.3, RV4.3, U8.COLL
GND: C13.1, J7.2, J8.2, J9.2, J10.2, J11.2, U5.CATH, U5.E, U6.CATH, U6.E, U7.CATH, U7.E, U8.CATH, U8.E; also elsewhere on the board
unnamed: J9.1, R7.1
unnamed: R3.2, U5.A
unnamed: R4.2, U6.A
unnamed: R5.2, U7.A
unnamed: R6.2, U8.A
P8: J9.3, R8.1; also elsewhere on the board

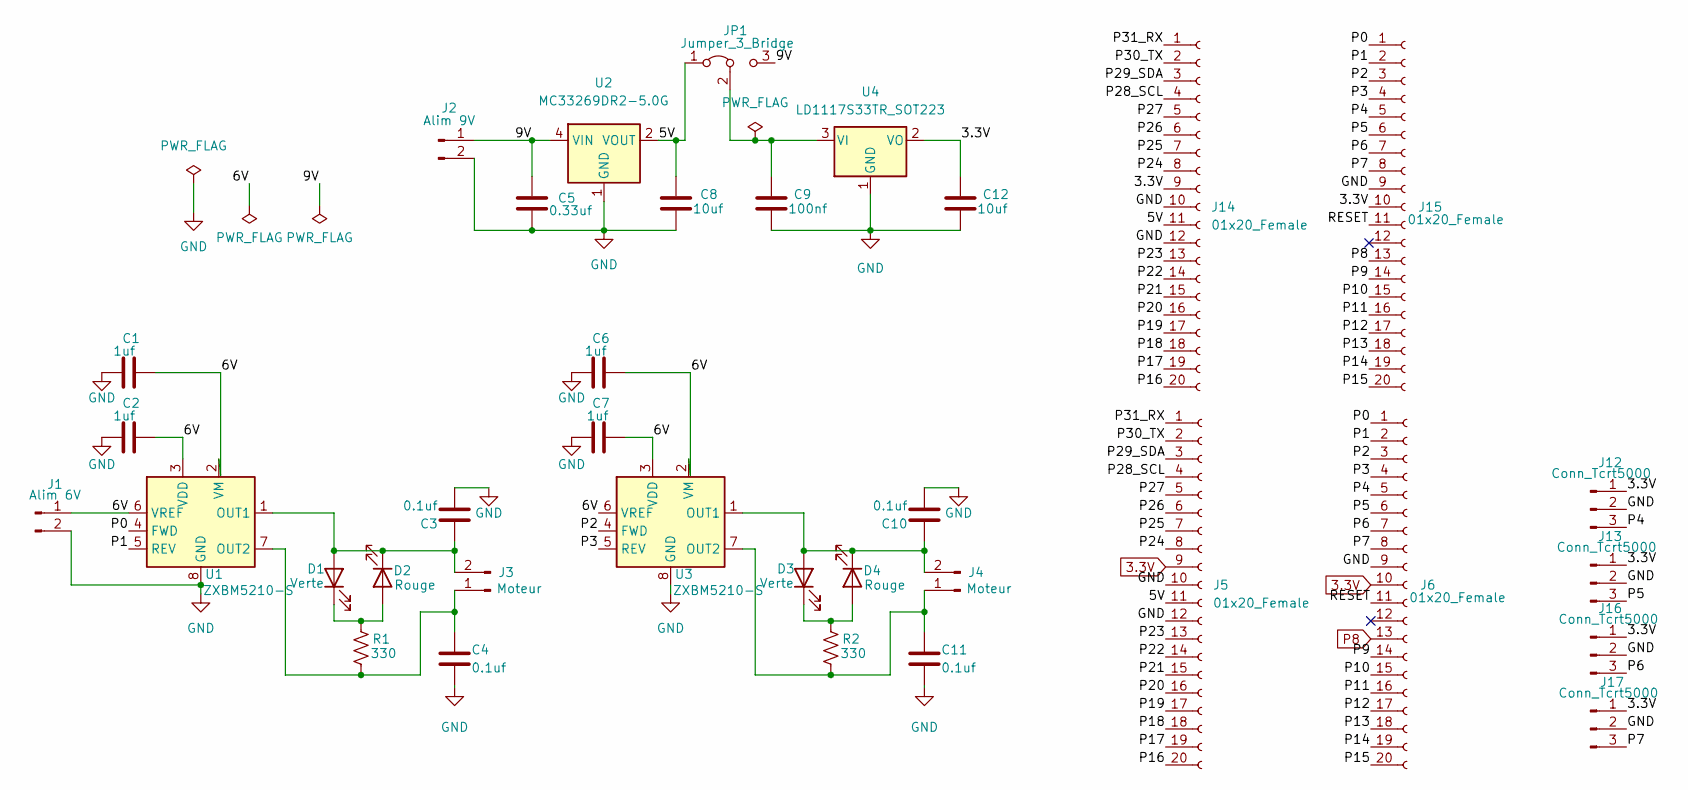
[picture p91: schematic untitled.kicad_sch]

Parts:
C1, C2, C6, C7: 1uf; C_0805_2012Metric_Pad1.18x1.45mm_HandSolder
C3, C4, C10, C11: 0.1uf; C_0805_2012Metric_Pad1.18x1.45mm_HandSolder
C5: 0.33uf; C_0805_2012Metric_Pad1.18x1.45mm_HandSolder
C8, C12: 10uf; C_0805_2012Metric_Pad1.18x1.45mm_HandSolder
C9: 100nf; C_0805_2012Metric_Pad1.18x1.45mm_HandSolder
D1, D3: Verte; D_0805_2012Metric_Pad1.15x1.40mm_HandSolder
D2, D4: Rouge; D_0805_2012Metric_Pad1.15x1.40mm_HandSolder
J1: Alim 6V; PinHeader_1x02_P2.54mm_Vertical
J2: Alim 9V; PinHeader_1x02_P2.54mm_Vertical
J3, J4: Moteur; PinHeader_1x02_P2.54mm_Vertical
J5, J6, J14, J15: 01x20_Female; PinSocket_1x20_P2.54mm_Vertical
J12, J13, J16, J17: Conn_Tcrt5000; PinHeader_1x03_P2.54mm_Vertical
JP1: Jumper_3_Bridge; PinHeader_1x03_P2.54mm_Vertical
R1, R2: 330; R_0805_2012Metric_Pad1.20x1.40mm_HandSolder
U1, U3: ZXBM5210-S; SOIC-8_3.9x4.9mm_P1.27mm
U2: MC33269DR2-5.0G; SOIC-8_3.9x4.9mm_P1.27mm
U4: LD1117S33TR_SOT223; TO-252-2

Connections:
3.3V: C12.1, J5.9, J6.10, J12.1, J13.1, J14.9, J15.10, J16.1, J17.1, U4.2 (VO); also elsewhere on the board
/Carte Mere/5V: C8.1, J5.11, J14.11, JP1.1 (A), U2.2 (VOUT), U2.3 (VOUT), U2.6 (VOUT), U2.7 (VOUT)
/Carte Mere/6V: C1.1, C2.1, C6.1, C7.1, J1.1, U1.2 (VM), U1.3 (VDD), U1.6 (VREF), U3.2 (VM), U3.3 (VDD), U3.6 (VREF)
/Carte Mere/9V: C5.1, J2.1, JP1.3 (B), U2.4 (VIN)
/Carte Mere/P0: J6.1, J15.1, U1.4 (FWD)
/Carte Mere/P1: J6.2, J15.2, U1.5 (REV)
/Carte Mere/P2: J6.3, J15.3, U3.4 (FWD)
/Carte Mere/P3: J6.4, J15.4, U3.5 (REV)
/Carte Mere/P4: J6.5, J12.3, J15.5
/Carte Mere/P5: J6.6, J13.3, J15.6
/Carte Mere/P6: J6.7, J15.7, J16.3
/Carte Mere/P7: J6.8, J15.8, J17.3
/Carte Mere/P9: J6.14, J15.14
/Carte Mere/P10: J6.15, J15.15
/Carte Mere/P11: J6.16, J15.16
/Carte Mere/P12: J6.17, J15.17
/Carte Mere/P13: J6.18, J15.18
/Carte Mere/P14: J6.19, J15.19
/Carte Mere/P15: J6.20, J15.20
/Carte Mere/P16: J5.20, J14.20
/Carte Mere/P17: J5.19, J14.19
/Carte Mere/P18: J5.18, J14.18
/Carte Mere/P19: J5.17, J14.17
/Carte Mere/P20: J5.16, J14.16
/Carte Mere/P21: J5.15, J14.15
/Carte Mere/P22: J5.14, J14.14
/Carte Mere/P23: J5.13, J14.13
/Carte Mere/P24: J5.8, J14.8
/Carte Mere/P25: J5.7, J14.7
/Carte Mere/P26: J5.6, J14.6
/Carte Mere/P27: J5.5, J14.5
/Carte Mere/P28_SCL: J5.4, J14.4
/Carte Mere/P29_SDA: J5.3, J14.3
/Carte Mere/P30_TX: J5.2, J14.2
/Carte Mere/P31_RX: J5.1, J14.1
/Carte Mere/RESET: J6.11, J15.11
GND: C1.2, C2.2, C3.2, C4.2, C5.2, C6.2, C7.2, C8.2, C9.2, C10.2, C11.2, C12.2, J1.2, J2.2, J5.10, J5.12, J6.9, J12.2, J13.2, J14.10, J14.12, J15.9, J16.2, J17.2, U1.8 (GND), U2.1 (GND), U3.8 (GND), U4.1 (GND); also elsewhere on the board
unnamed: C3.1, D1.2 (A), D2.1 (K), J3.2, U1.1 (OUT1)
unnamed: C4.1, J3.1, R1.1, U1.7 (OUT2)
unnamed: C9.1, JP1.2 (C), U4.3 (VI)
unnamed: C10.1, D3.2 (A), D4.1 (K), J4.2, U3.1 (OUT1)
unnamed: C11.1, J4.1, R2.1, U3.7 (OUT2)
unnamed: D1.1 (K), D2.2 (A), R1.2
unnamed: D3.1 (K), D4.2 (A), R2.2
P8: J6.13, J15.13; also elsewhere on the board

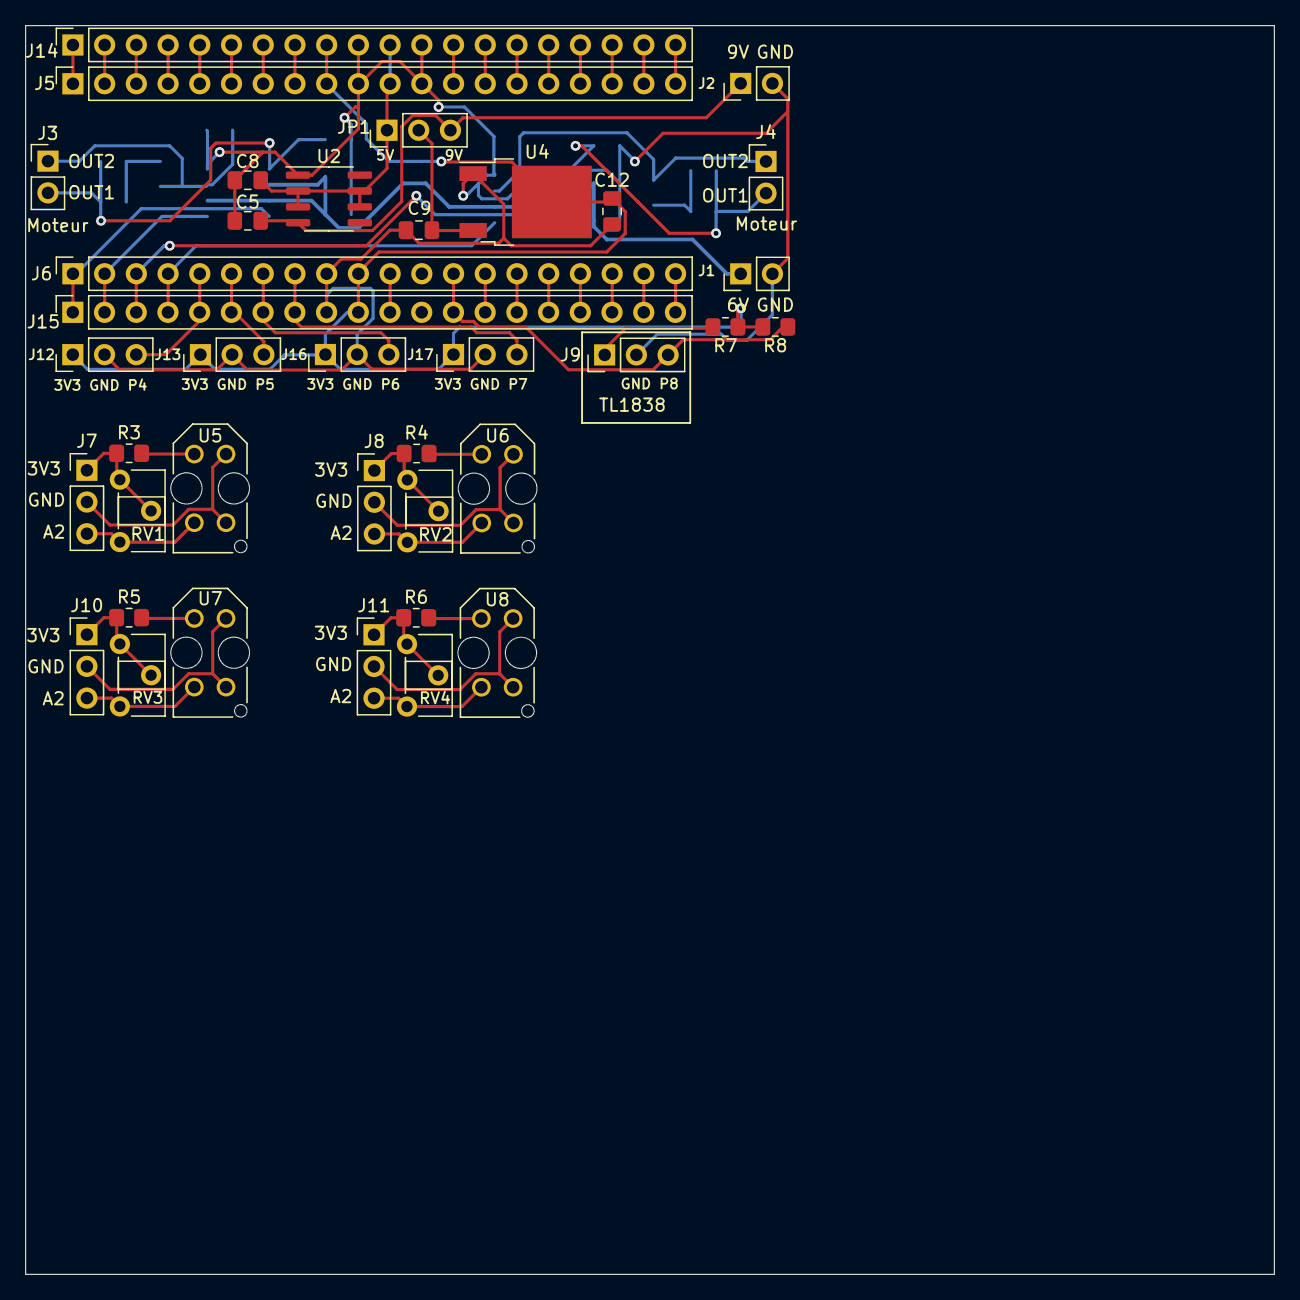
[picture p92: board Carte Mere.kicad_pcb from above]

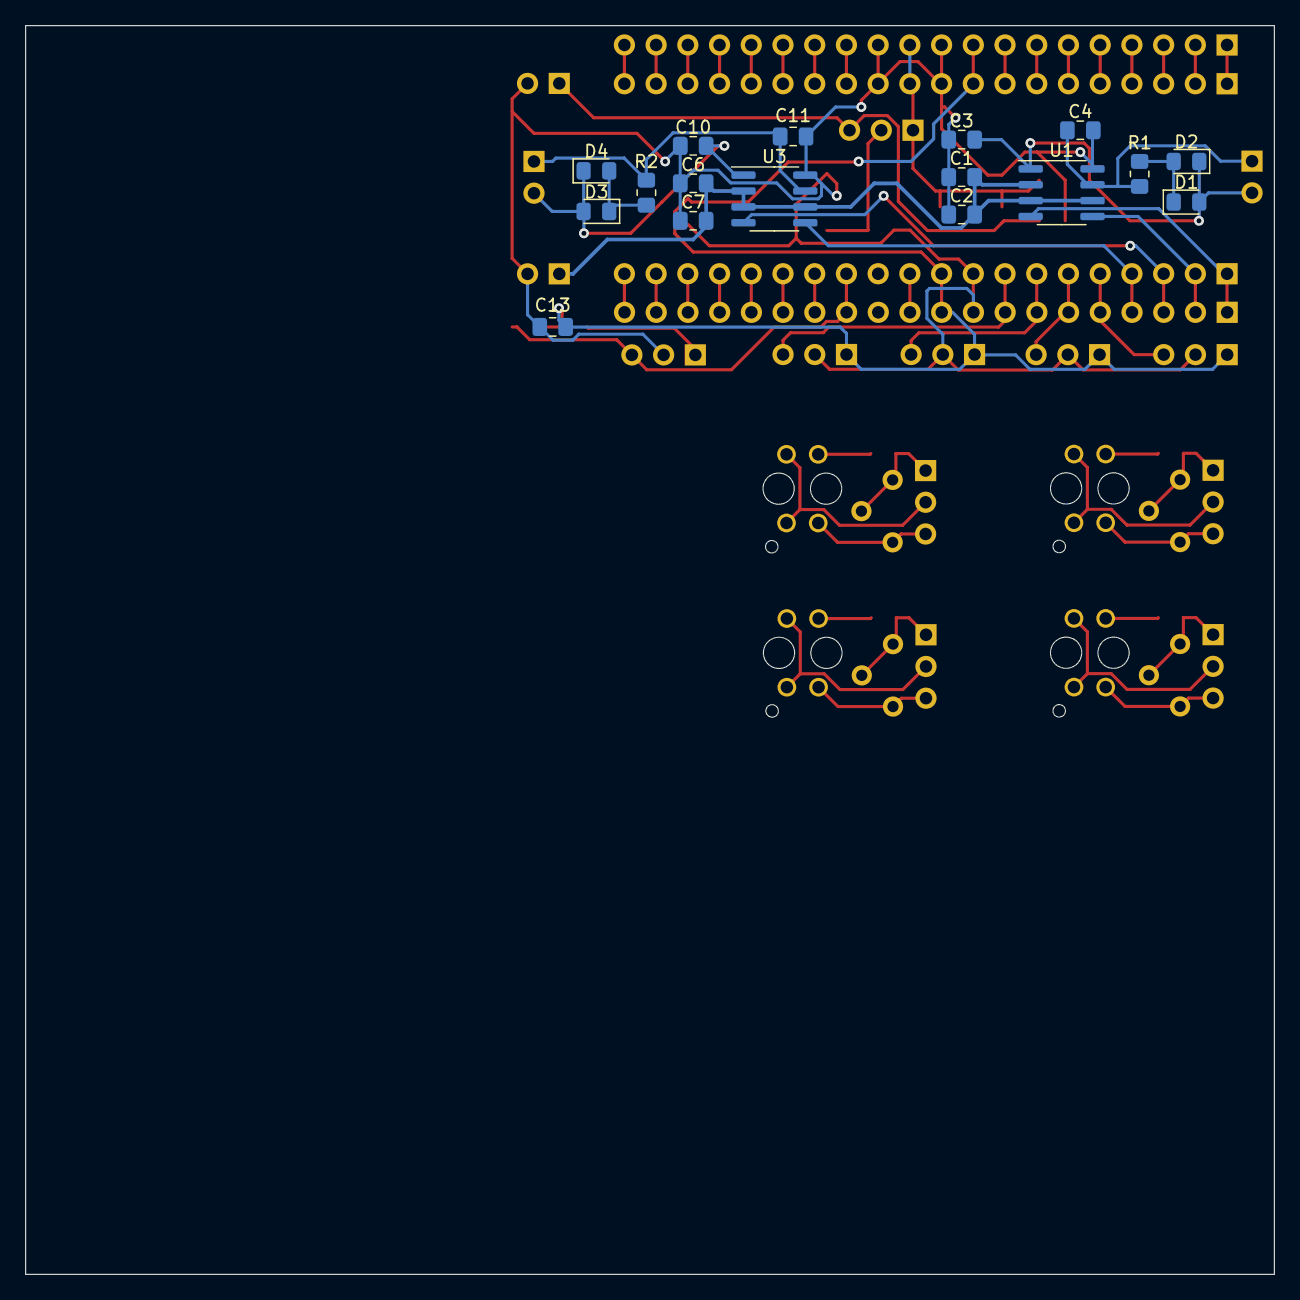
[picture p93: board Carte Mere.kicad_pcb from below]

Board: 4 copper layers, 100.0 x 100.0 mm, 55 parts (17 on the bottom side), 54 nets.
