FishyG/RobotSumo2022/PCB/PowerSupply/PowerSupply/PowerSupply.kicad_pcb

## KiCad design PCB/PowerSupply/PowerSupply/PowerSupply.kicad_pcb (2022-09-16)

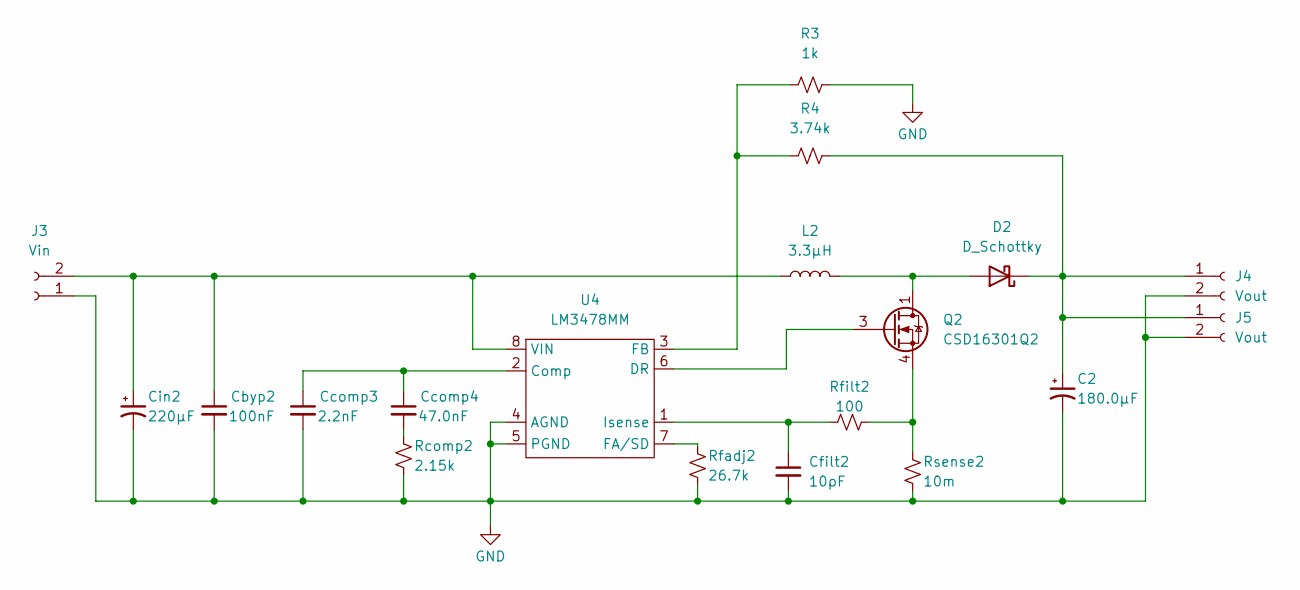
[picture p94: schematic PowerSupply_9V.kicad_sch]

Parts:
C2: 180.0μF; CP_Elec_10x10
Cbyp2: 100nF; C_0805_2012Metric_Pad1.18x1.45mm_HandSolder
Ccomp3: 2.2nF; C_0805_2012Metric_Pad1.18x1.45mm_HandSolder
Ccomp4: 47.0nF; R_0805_2012Metric_Pad1.20x1.40mm_HandSolder
Cfilt2: 10ρF; C_0805_2012Metric_Pad1.18x1.45mm_HandSolder
Cin2: 220µF; C_0805_2012Metric_Pad1.18x1.45mm_HandSolder
D2: D_Schottky; D_SMB-SMC_Universal_Handsoldering
J3: Vin; PinHeader_1x02_P2.54mm_Vertical
J4, J5: Vout; PinHeader_1x02_P2.54mm_Vertical
L2: 3.3µH; L_TDK_VLP8040
Q2: CSD16301Q2; Texas_DQK
R3: 1k; R_0805_2012Metric_Pad1.20x1.40mm_HandSolder
R4: 3.74k; R_0805_2012Metric_Pad1.20x1.40mm_HandSolder
Rcomp2: 2.15k; R_0805_2012Metric_Pad1.20x1.40mm_HandSolder
Rfadj2: 26.7k; R_0805_2012Metric_Pad1.20x1.40mm_HandSolder
Rfilt2: 100; R_0805_2012Metric_Pad1.20x1.40mm_HandSolder
Rsense2: 10m; R_1206_3216Metric_Pad1.30x1.75mm_HandSolder
U4: LM3478MM; SOIC-8-1EP_3.9x4.9mm_P1.27mm_EP2.29x3mm

Connections:
GND: C2.2, Cbyp2.2, Ccomp3.2, Cfilt2.2, Cin2.2, J3.1, J4.2, J5.2, R3.2, Rcomp2.2, Rfadj2.2, Rsense2.2, U4.4 (AGND), U4.5 (PGND); also elsewhere on the board
unnamed: C2.1, D2.1 (K), J4.1, J5.1, R4.2
unnamed: Cbyp2.1, Cin2.1, J3.2, L2.1, U4.8 (VIN)
unnamed: Ccomp3.1, Ccomp4.1, U4.2 (Comp)
unnamed: Ccomp4.2, Rcomp2.1
unnamed: Cfilt2.1, Rfilt2.1, U4.1 (Isense)
unnamed: D2.2 (A), L2.2, Q2.1 (D), Q2.2 (D), Q2.5 (D), Q2.6 (D), Q2.8 (D)
unnamed: Q2.3 (G), U4.6 (DR)
unnamed: Q2.4 (S), Q2.7 (S), Rfilt2.2, Rsense2.1
unnamed: R3.1, R4.1, U4.3 (FB)
unnamed: Rfadj2.1, U4.7 (FA/SD)

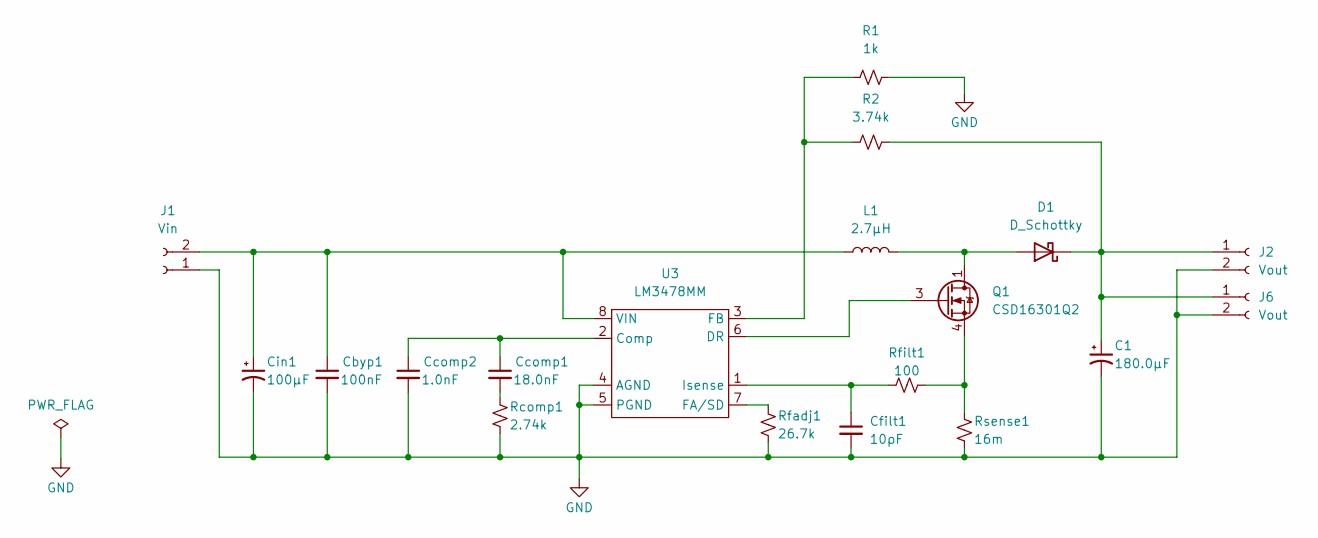
[picture p95: schematic PowerSupply_6V.kicad_sch]

Parts:
C1: 180.0μF; CP_Elec_10x10
Cbyp1: 100nF; C_0805_2012Metric_Pad1.18x1.45mm_HandSolder
Ccomp1: 18.0nF; R_0805_2012Metric_Pad1.20x1.40mm_HandSolder
Ccomp2: 1.0nF; C_0805_2012Metric_Pad1.18x1.45mm_HandSolder
Cfilt1: 10ρF; C_0805_2012Metric_Pad1.18x1.45mm_HandSolder
Cin1: 100µF; C_0805_2012Metric_Pad1.18x1.45mm_HandSolder
D1: D_Schottky; D_SMB-SMC_Universal_Handsoldering
J1: Vin; PinHeader_1x02_P2.54mm_Vertical
J2, J6: Vout; PinHeader_1x02_P2.54mm_Vertical
L1: 2.7µH; L_TDK_VLP8040
Q1: CSD16301Q2; Texas_DQK
R1: 1k; R_0805_2012Metric_Pad1.20x1.40mm_HandSolder
R2: 3.74k; R_0805_2012Metric_Pad1.20x1.40mm_HandSolder
Rcomp1: 2.74k; R_0805_2012Metric_Pad1.20x1.40mm_HandSolder
Rfadj1: 26.7k; R_0805_2012Metric_Pad1.20x1.40mm_HandSolder
Rfilt1: 100; R_0805_2012Metric_Pad1.20x1.40mm_HandSolder
Rsense1: 16m; R_1206_3216Metric_Pad1.30x1.75mm_HandSolder
U3: LM3478MM; SOIC-8-1EP_3.9x4.9mm_P1.27mm_EP2.29x3mm

Connections:
GND: C1.2, Cbyp1.2, Ccomp2.2, Cfilt1.2, Cin1.2, J1.1, J2.2, J6.2, R1.2, Rcomp1.2, Rfadj1.2, Rsense1.2, U3.4 (AGND), U3.5 (PGND); also elsewhere on the board
unnamed: C1.1, D1.1 (K), J2.1, J6.1, R2.2
unnamed: Cbyp1.1, Cin1.1, J1.2, L1.1, U3.8 (VIN)
unnamed: Ccomp1.1, Ccomp2.1, U3.2 (Comp)
unnamed: Ccomp1.2, Rcomp1.1
unnamed: Cfilt1.1, Rfilt1.1, U3.1 (Isense)
unnamed: D1.2 (A), L1.2, Q1.1 (D), Q1.2 (D), Q1.5 (D), Q1.6 (D), Q1.8 (D)
unnamed: Q1.3 (G), U3.6 (DR)
unnamed: Q1.4 (S), Q1.7 (S), Rfilt1.2, Rsense1.1
unnamed: R1.1, R2.1, U3.3 (FB)
unnamed: Rfadj1.1, U3.7 (FA/SD)

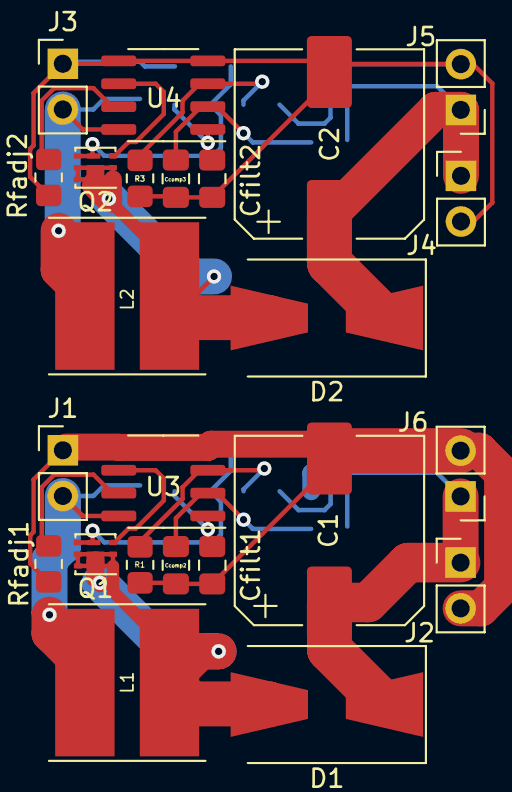
[picture p96: board PowerSupply.kicad_pcb from above]

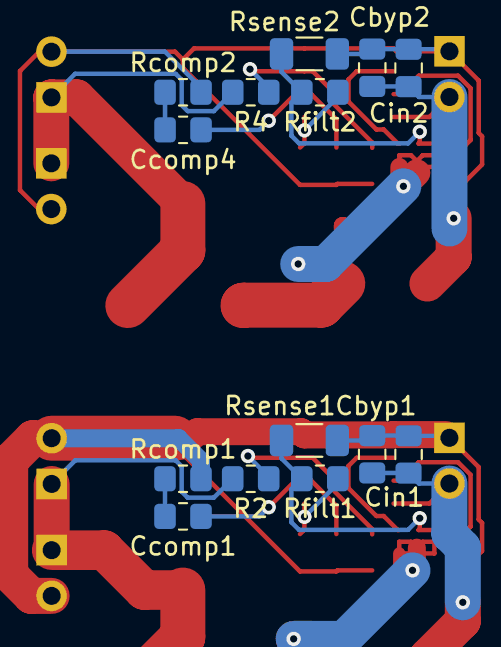
[picture p97: board PowerSupply.kicad_pcb from below]

Board: 2 copper layers, 38 parts (14 on the bottom side), 21 nets.
