FishyG/RobotSumo2022/(commit log)

2022-08-25 Added Datasheet + PCB
    [PowerSupply.kicad_pcb, PowerSupply.kicad_sch]
2022-08-25 Updated parts
    [PowerSupply.kicad_sch]
2022-09-01 Added datasheet + Kicad modif
    [PowerSupply.kicad_sch, PowerSupply_6V.kicad_sch, PowerSupply_9V.kicad_sch]
2022-09-01 Finalized both power supply
    [PowerSupply.kicad_sch, PowerSupply_6V.kicad_sch, PowerSupply_9V.kicad_sch]
2022-09-01 Version 1.0
    [Carte Mere.kicad_sch, untitled.kicad_sch]
2022-09-08 1.2 PCB
    [Capteur infrarouge.kicad_sch, Carte Mere.kicad_pcb, Carte Mere.kicad_sch, untitled.kicad_sch]
2022-09-08 1.4 Carte mere
    [Carte Mere.kicad_pcb, untitled.kicad_sch]
2022-09-11 1.5 PCB
    [Capteur infrarouge.kicad_sch, Carte Mere.kicad_sch, TCRT5000.step]
2022-09-11 Fixed Zach's Stuff
    [Capteur infrarouge.kicad_sch, Carte Mere.kicad_pcb, PowerSupply.kicad_pcb, PowerSupply.kicad_sch, PowerSupply_9V.kicad_sch]
2022-09-11 added lib for tcrt5000
    [Carte Mere.kicad_pcb]
2022-09-11 fixed lib for tcrt5000 v2
    [BasicStamp2.kicad_sch, CpuBoard.kicad_pcb, CpuBoard.kicad_sch, Lab3_Projet2_CpuBoards.csv, Lab3_Projet2_CpuBoards.kicad_pcb, Lab3_Projet2_CpuBoards.kicad_sch, Propeller.kicad_sch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]
2022-09-11 Delete TCRT5000 directory
    Not needed
    [TCRT5000.step]
2022-09-13 Modif PCB + Datasheet
    [CpuBoard.kicad_pcb]
2022-09-13 Modif PCB + Datasheet v2
    [CpuBoard.kicad_sch]
2022-09-15 New Revision
    [CpuBoard.kicad_pcb, CpuBoard.kicad_sch, ESP-01.kicad_sch, Propeller.kicad_sch]
2022-09-15 2.0 alabama
    [Capteur infrarouge.kicad_sch, Carte Mere.kicad_pcb, Carte Mere.kicad_sch, untitled.kicad_sch]
2022-09-15 2.1 Missouri
    [Capteur infrarouge.kicad_sch, Carte Mere.kicad_pcb, Carte Mere.kicad_sch, untitled.kicad_sch]
2022-09-15 2.2 Florida
    [Capteur infrarouge.kicad_sch, Carte Mere.kicad_pcb, Carte Mere.kicad_sch, untitled.kicad_sch]
2022-09-16 Fixed Zach's errors :/ smh
    [BasicStamp2.kicad_sch, Capteur infrarouge.kicad_sch, Carte Mere.kicad_pcb, Carte Mere.kicad_sch, CpuBoard.kicad_pcb, CpuBoard.kicad_sch, Lab3_Projet2_CpuBoards.csv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]
2022-09-16 Finished v0.1
    [COMPLETE_PCB-B_Cu.gbr, COMPLETE_PCB-B_Mask.gbr, COMPLETE_PCB-B_Paste.gbr, COMPLETE_PCB-B_Silkscreen.gbr, COMPLETE_PCB-Edge_Cuts.gbr, COMPLETE_PCB-F_Cu.gbr, COMPLETE_PCB-F_Mask.gbr, COMPLETE_PCB-F_Paste.gbr]
2022-09-23 Documentation annexe
    [Capteur infrarouge.kicad_sch]
2022-09-25 Completed the power supply part
2022-10-06 added 3D parts + final version
    [18650_Holderl.stl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]
2022-11-24 Added the code
    [main.obj]
2022-12-01 Updated code and 3d files
    [18650_Holderl.stl, Capteur.step, CarteMere.stl, CpuBoard.stl, CpuBoardEsp.stl, DC_Motor_20mm.STEP, DC_Motor_20mm.STL, PowerSupply.step]
2022-12-09 Added the part to read from the second serial port
    [main.obj]
2022-12-15 Cool Shit
    [main.obj]
2022-12-21 Zachary Code
    [main.obj]
